markusheimerl/quadcopter/hardware/README.md

# quad
A quadcopter printed circuit board  

## How to use
Import .epro file at [https://pro.easyeda.com/editor](https://pro.easyeda.com/editor)

## Quickview

### Drone
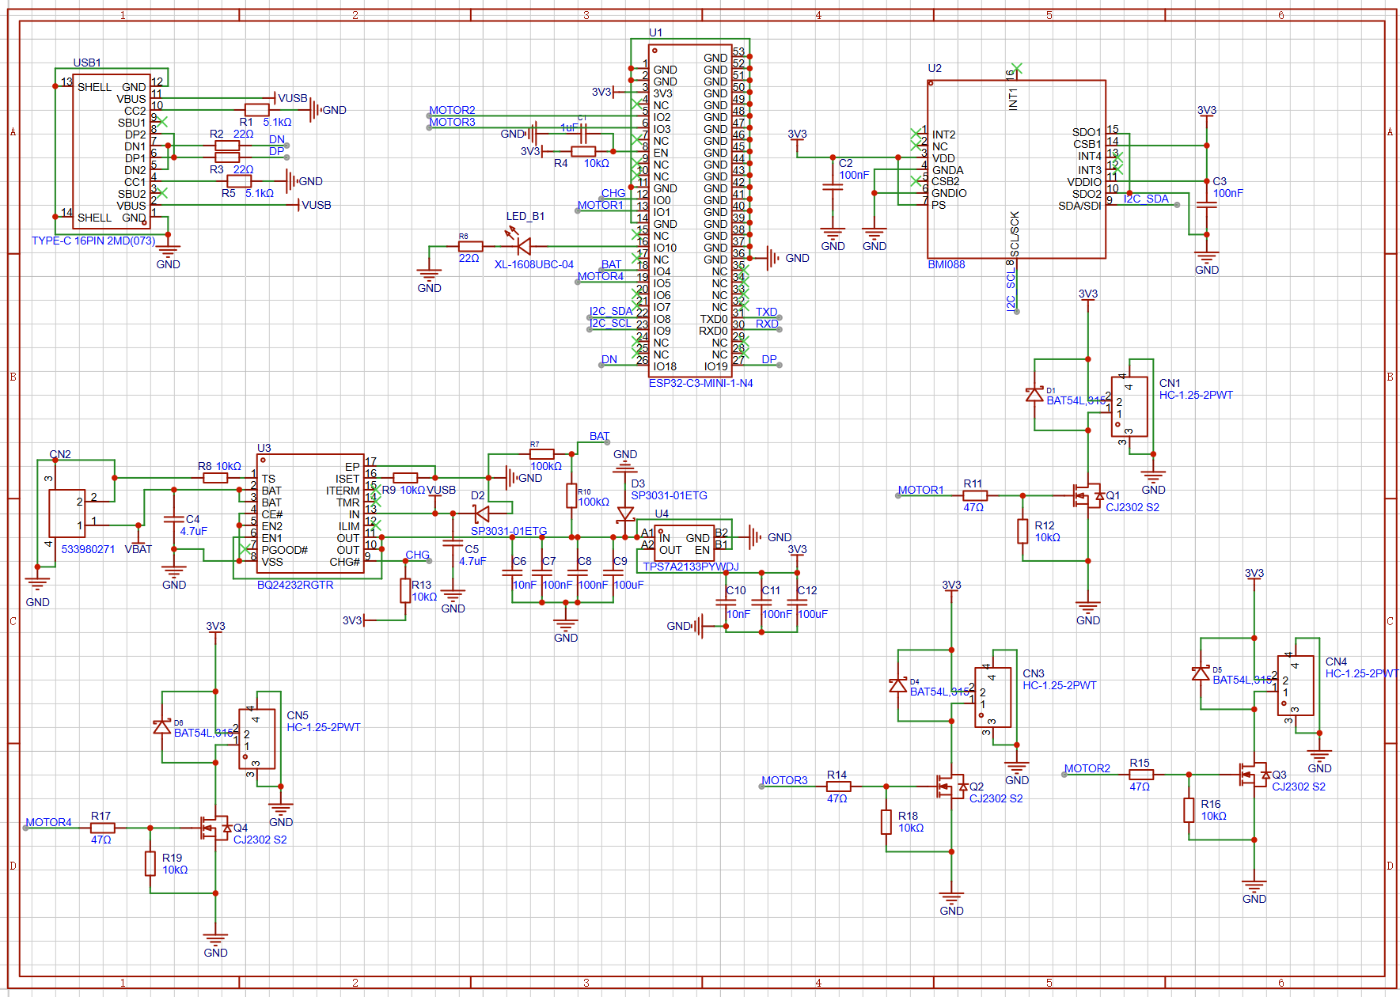
[picture p1: hardware/img/2025_11_15_drone_sch.png]
Drone Schematic

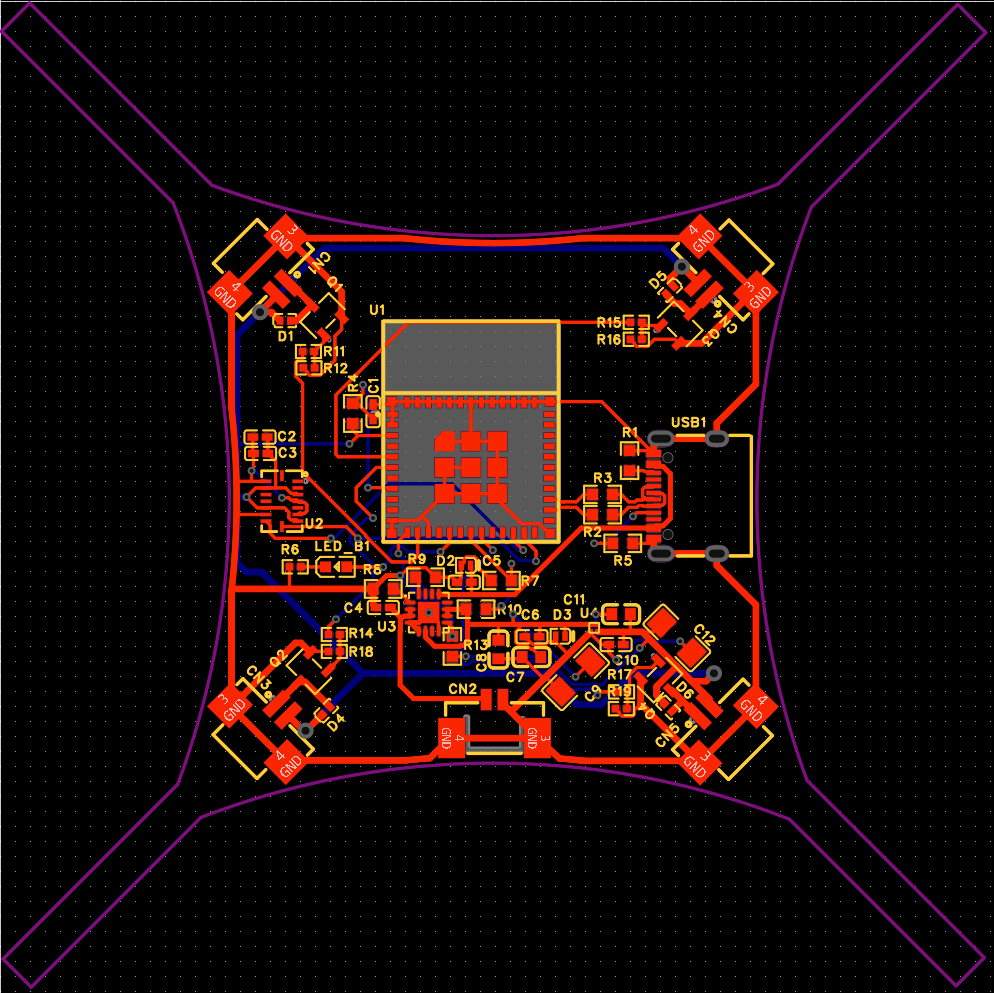
[picture p2: hardware/img/2025_11_15_drone_pcb.png]
Drone PCB


### ESP32
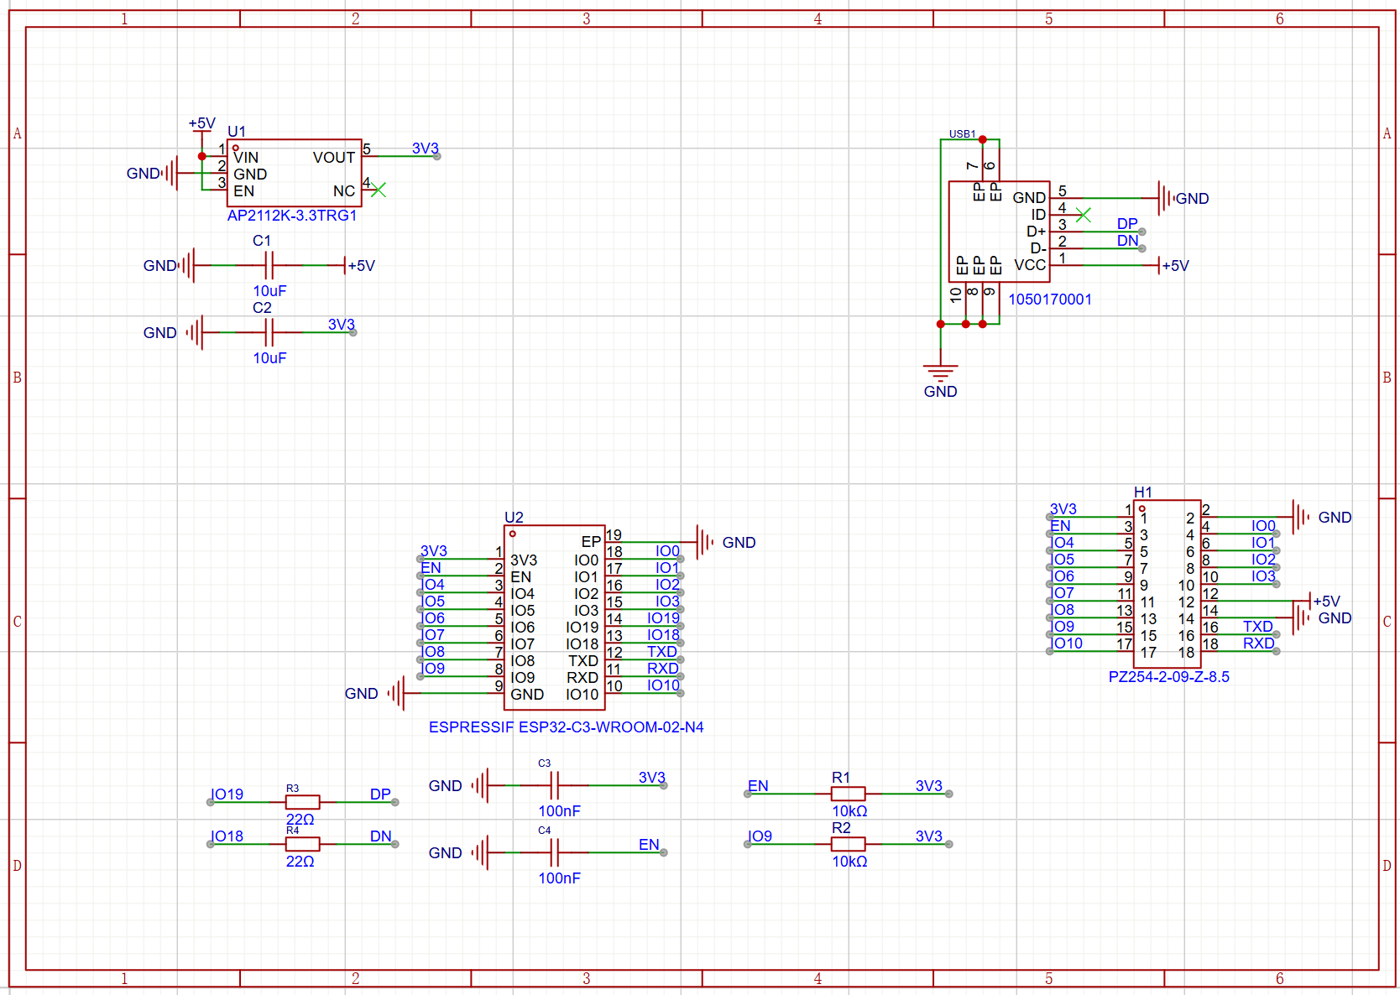
[picture p3: hardware/img/2025_10_02_esp32_sch.png]
ESP32 Schematic

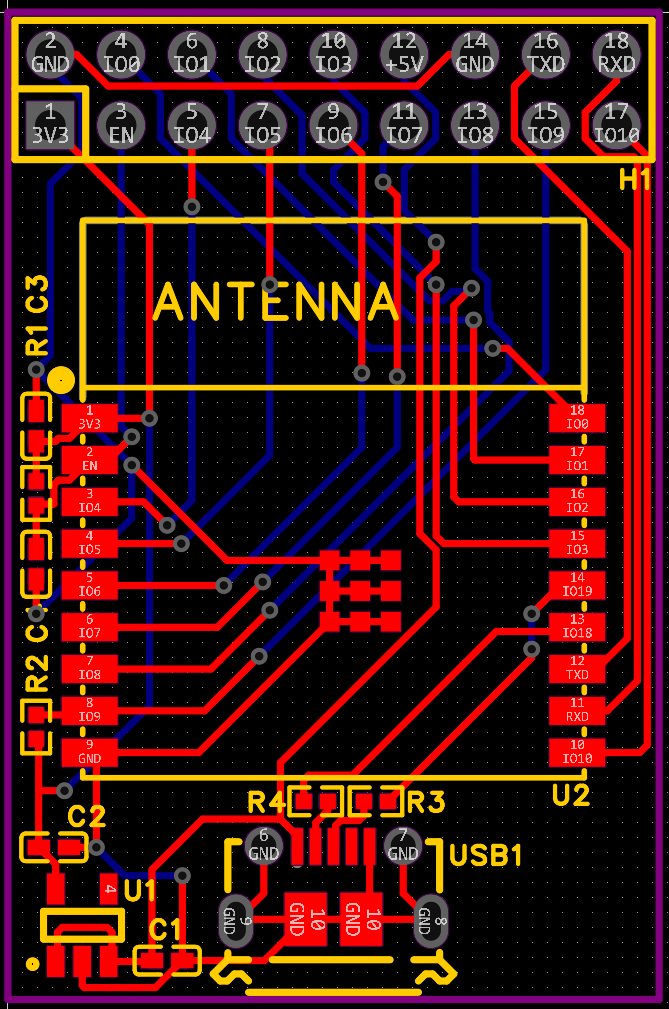
[picture p4: hardware/img/2025_10_02_esp32_pcb.png]
ESP32 PCB


### USB2SPI
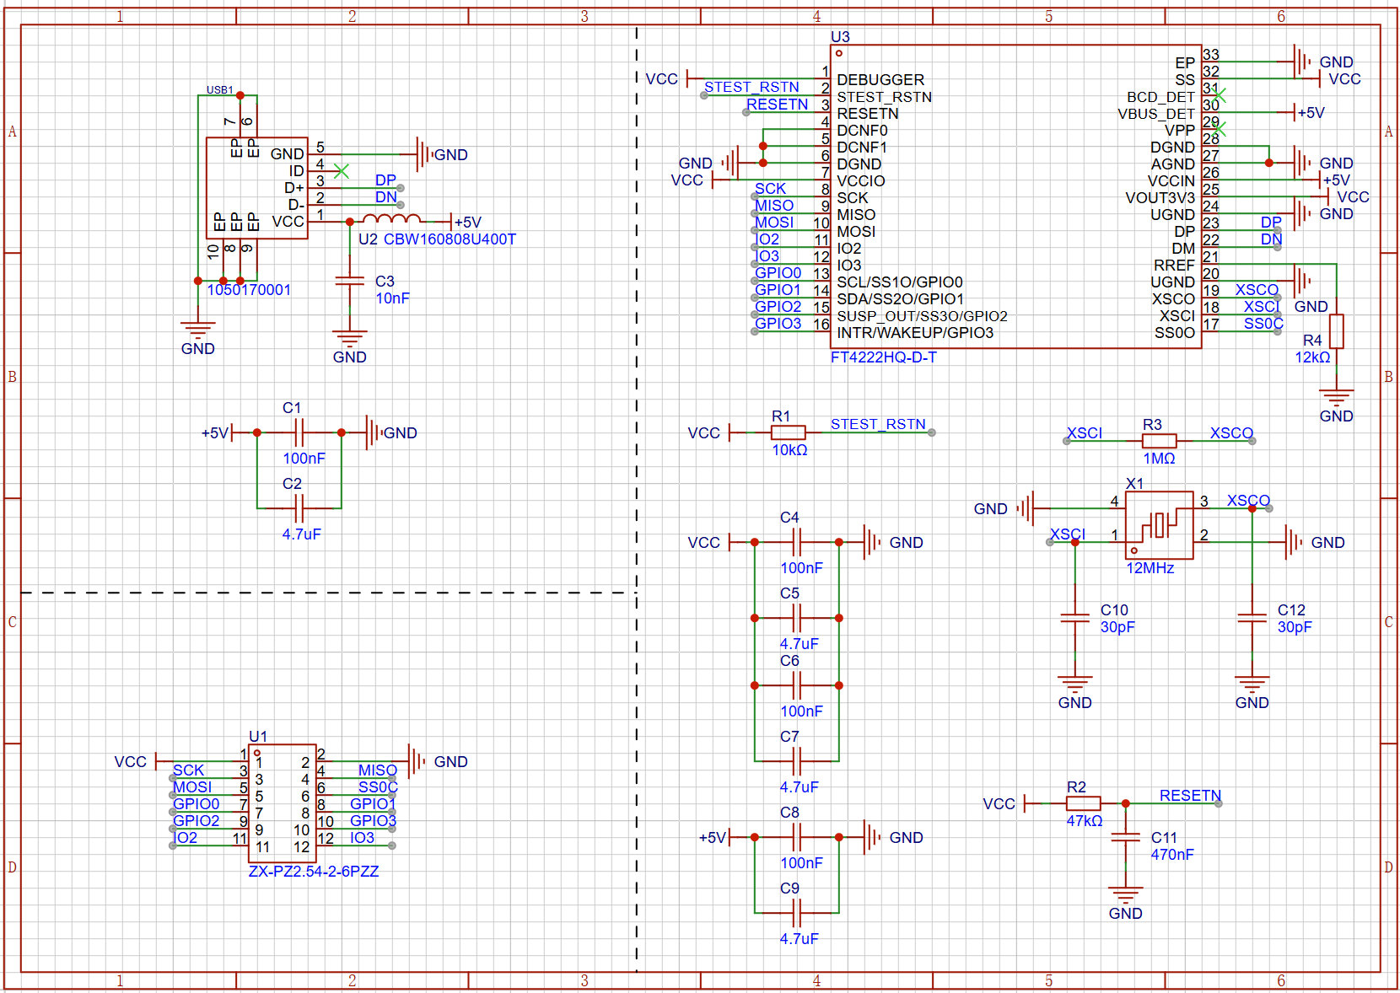
[picture p5: hardware/img/2025_09_11_usb2spi_sch.png]
FTDI Schematic

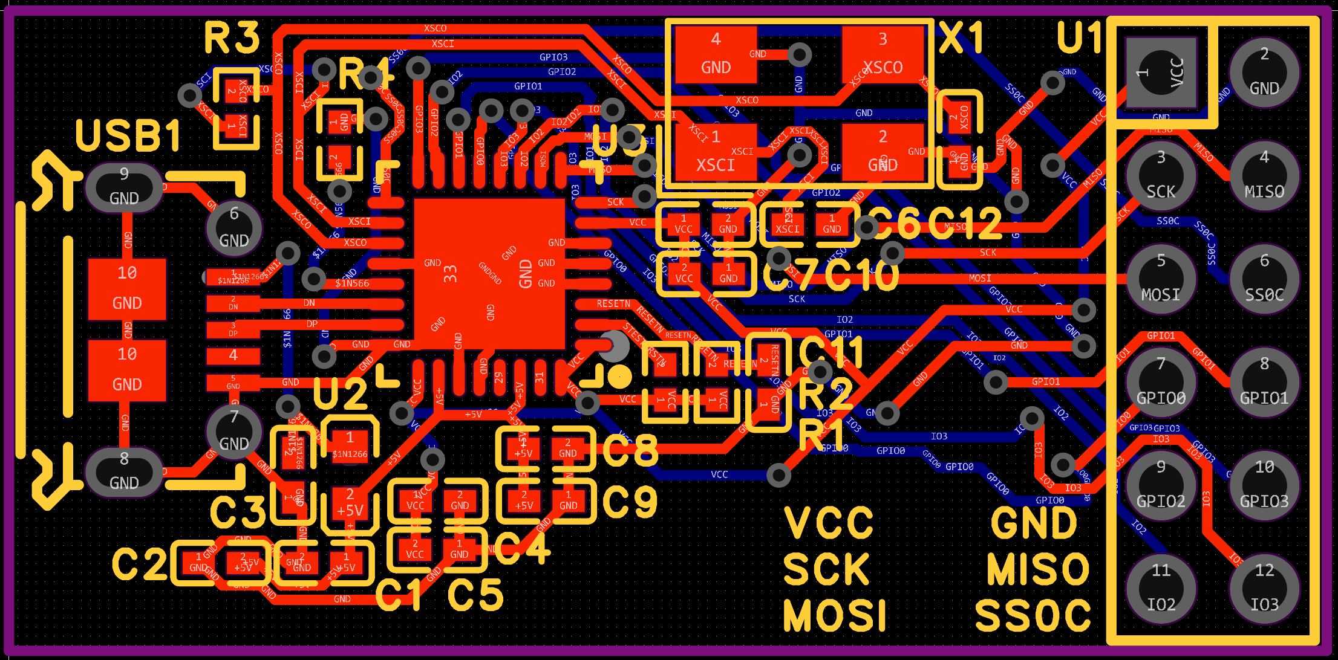
[picture p6: hardware/img/2025_09_11_usb2spi_pcb.png]
FTDI PCB


### FPGA
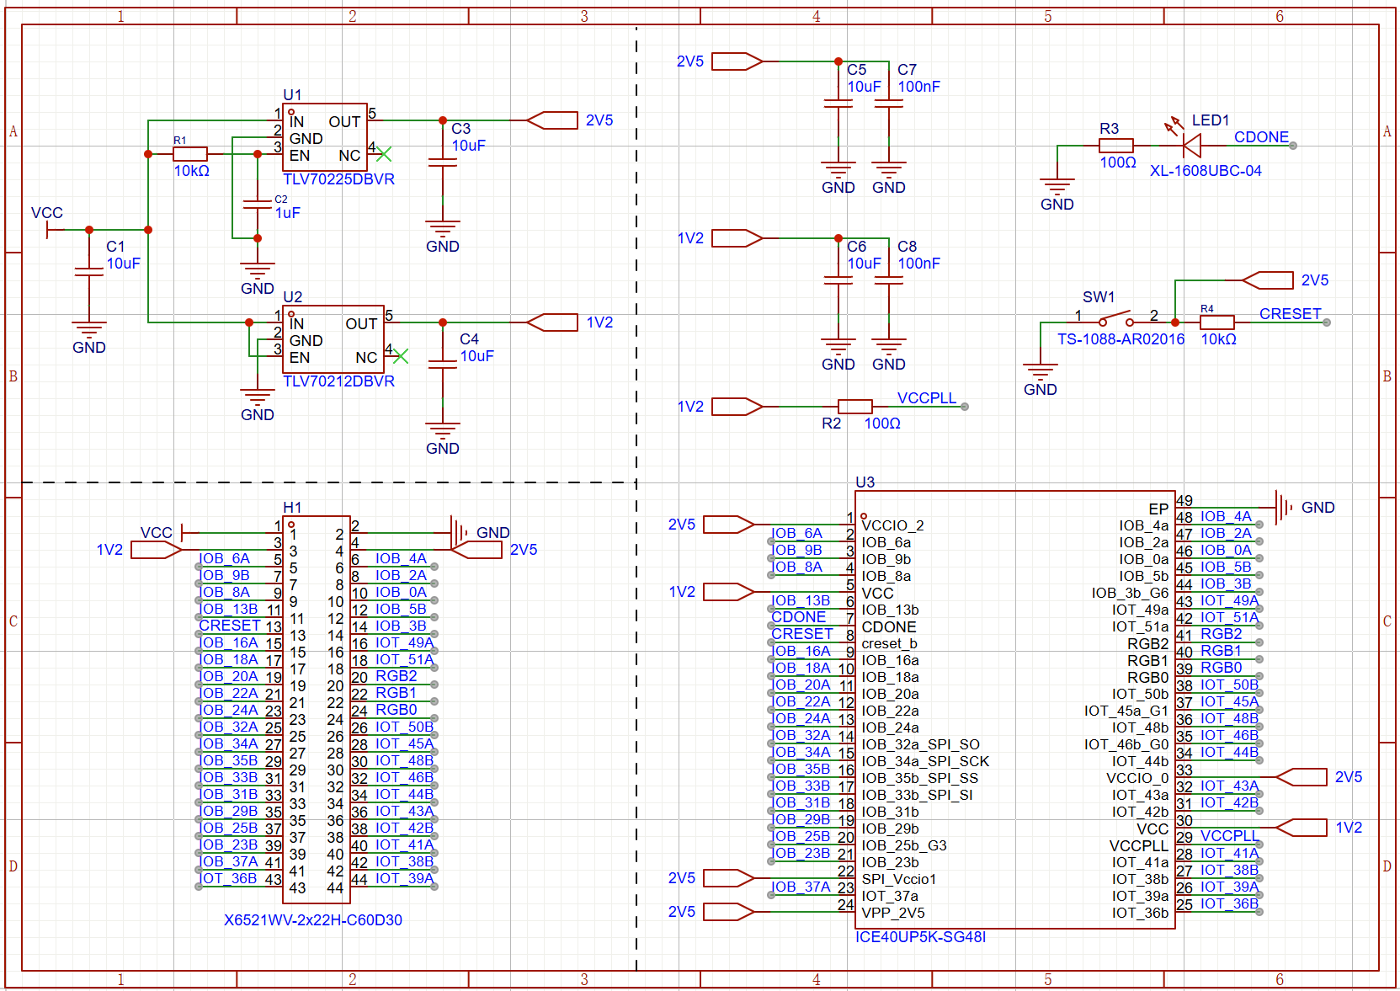
[picture p7: hardware/img/2025_08_20_fpga_sch.png]
FPGA Schematic

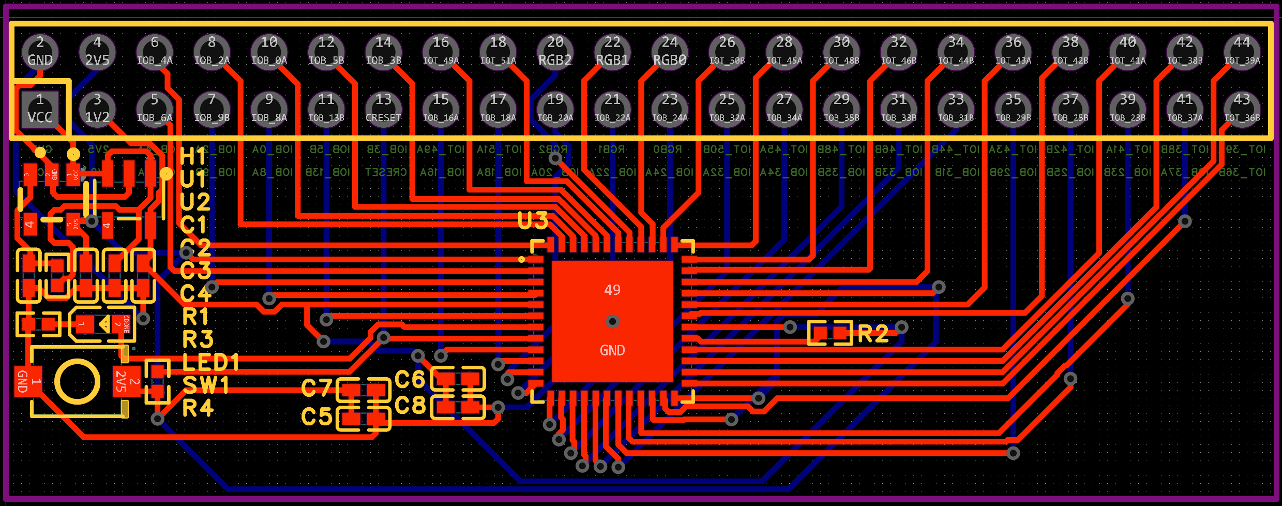
[picture p8: hardware/img/2025_08_20_fpga_pcb.png]
FPGA PCB


### DC
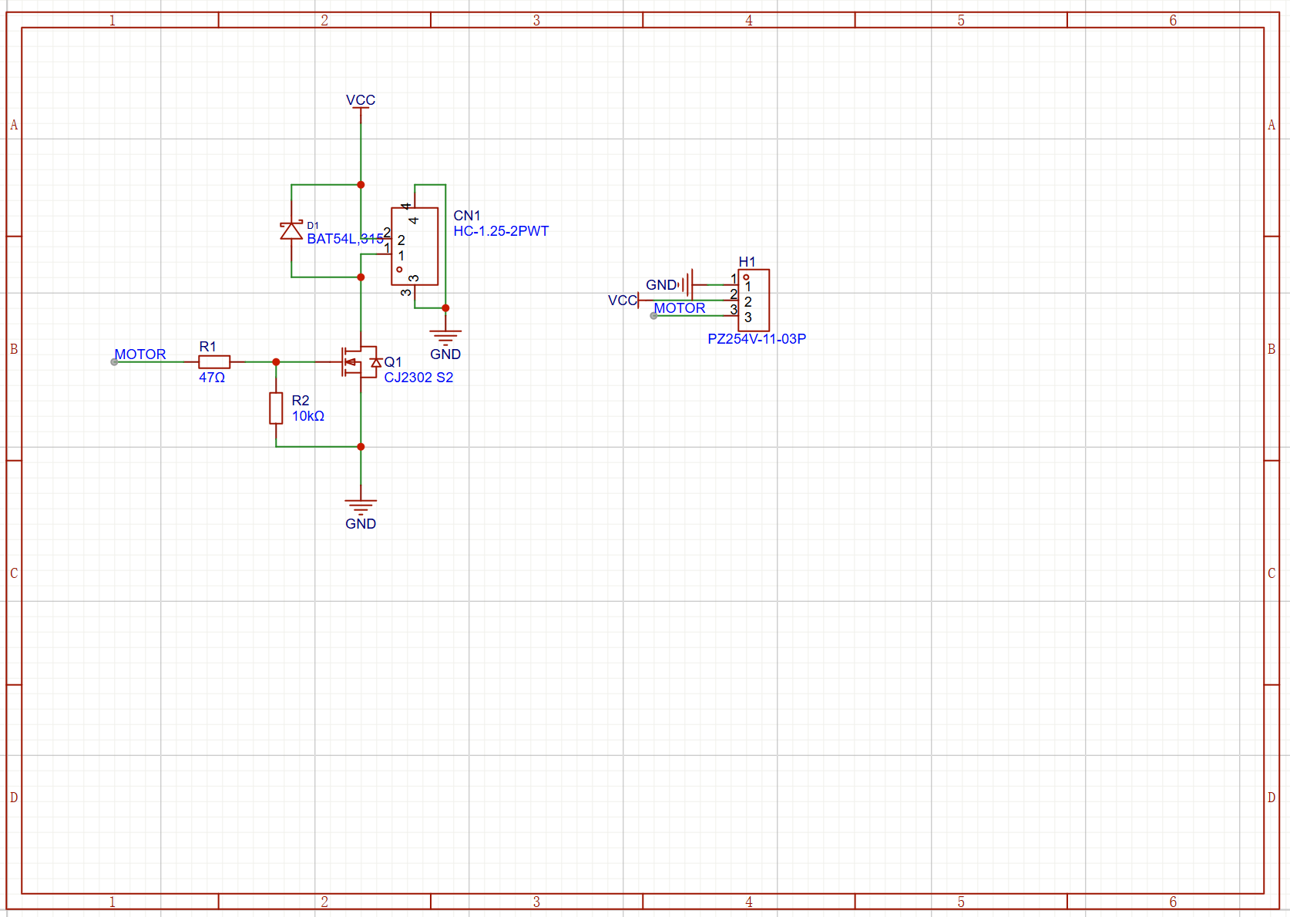
[picture p9: hardware/img/2025_09_06_dc_sch.png]
DC Schematic

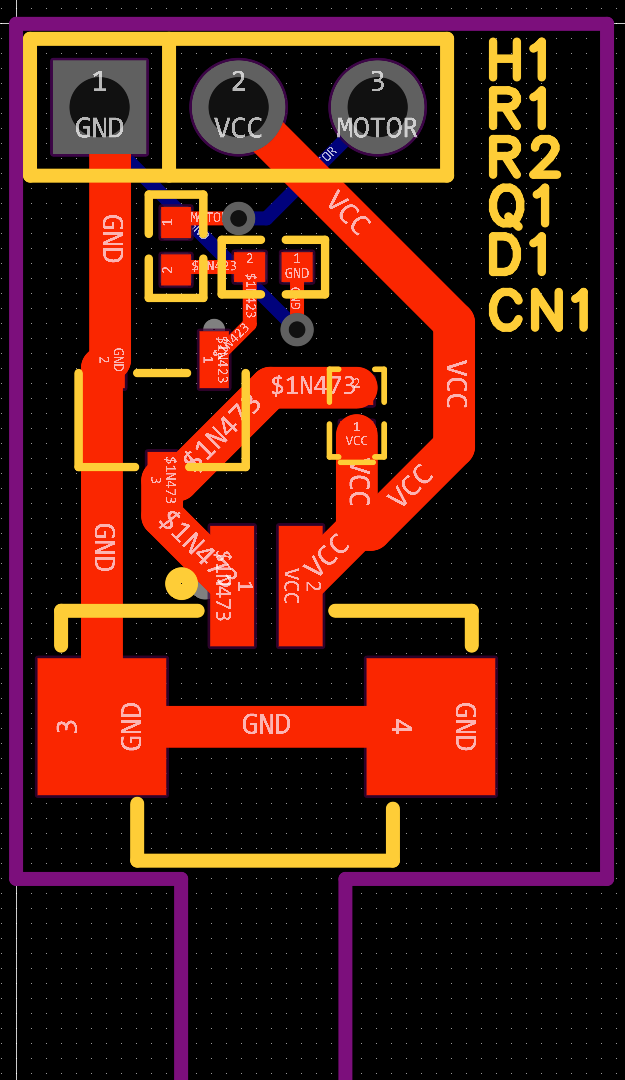
[picture p10: hardware/img/2025_09_06_dc_pcb.png]
DC PCB


### IMU
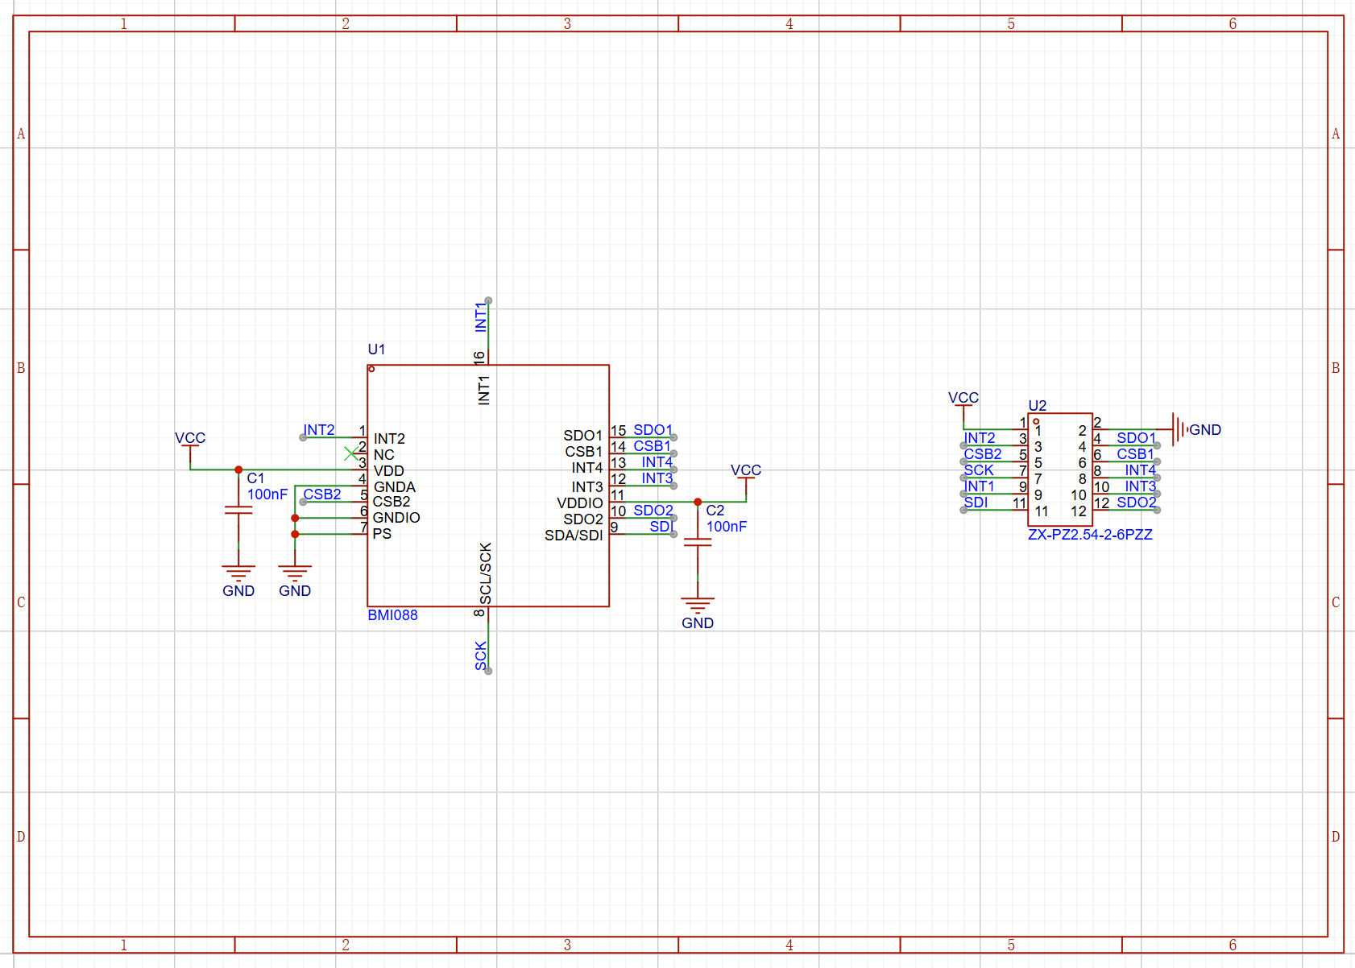
[picture p11: hardware/img/2025_07_18_imu_sch.png]
IMU Schematic

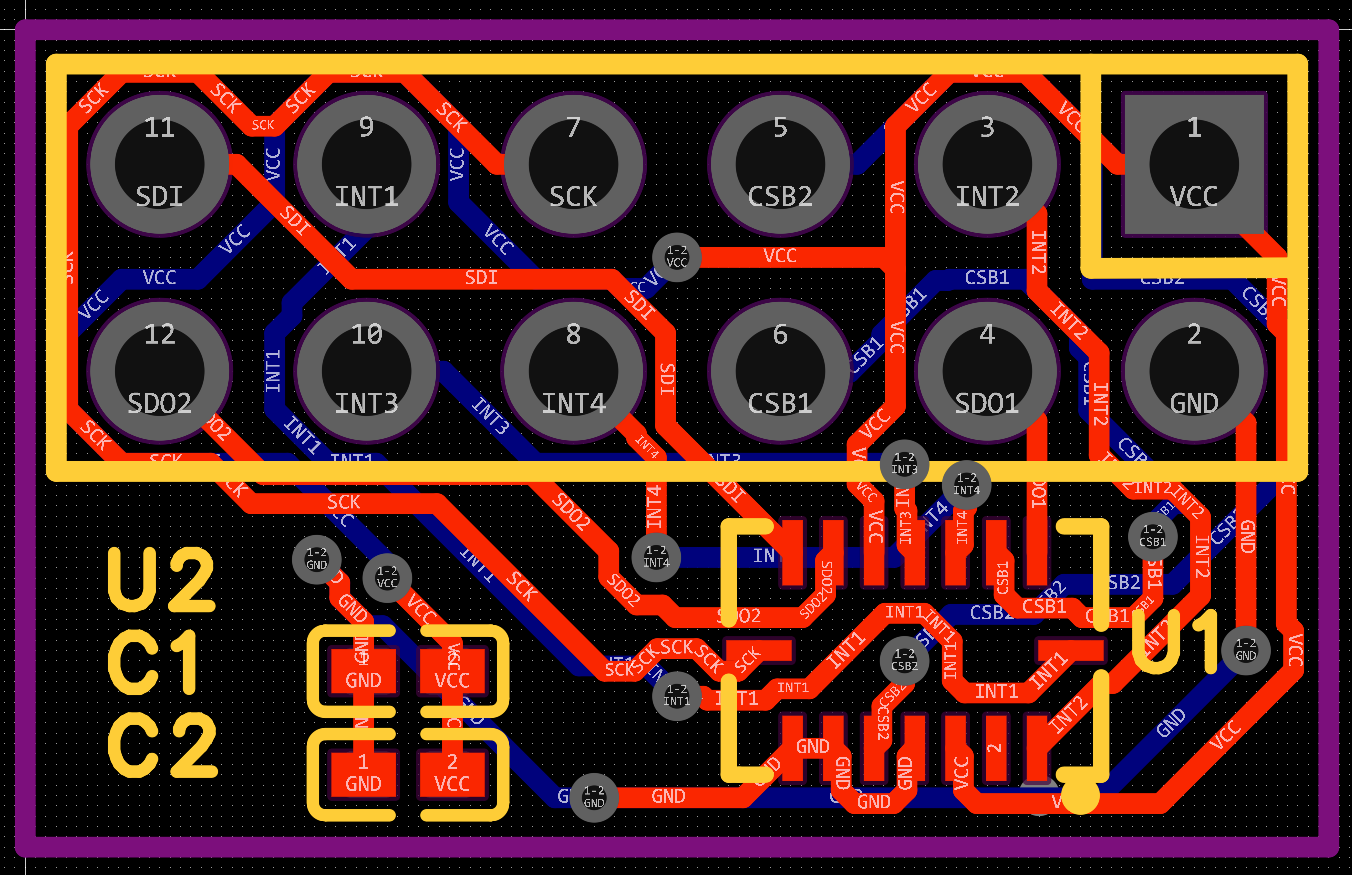
[picture p12: hardware/img/2025_07_18_imu_pcb.png]
IMU PCB


### Flash
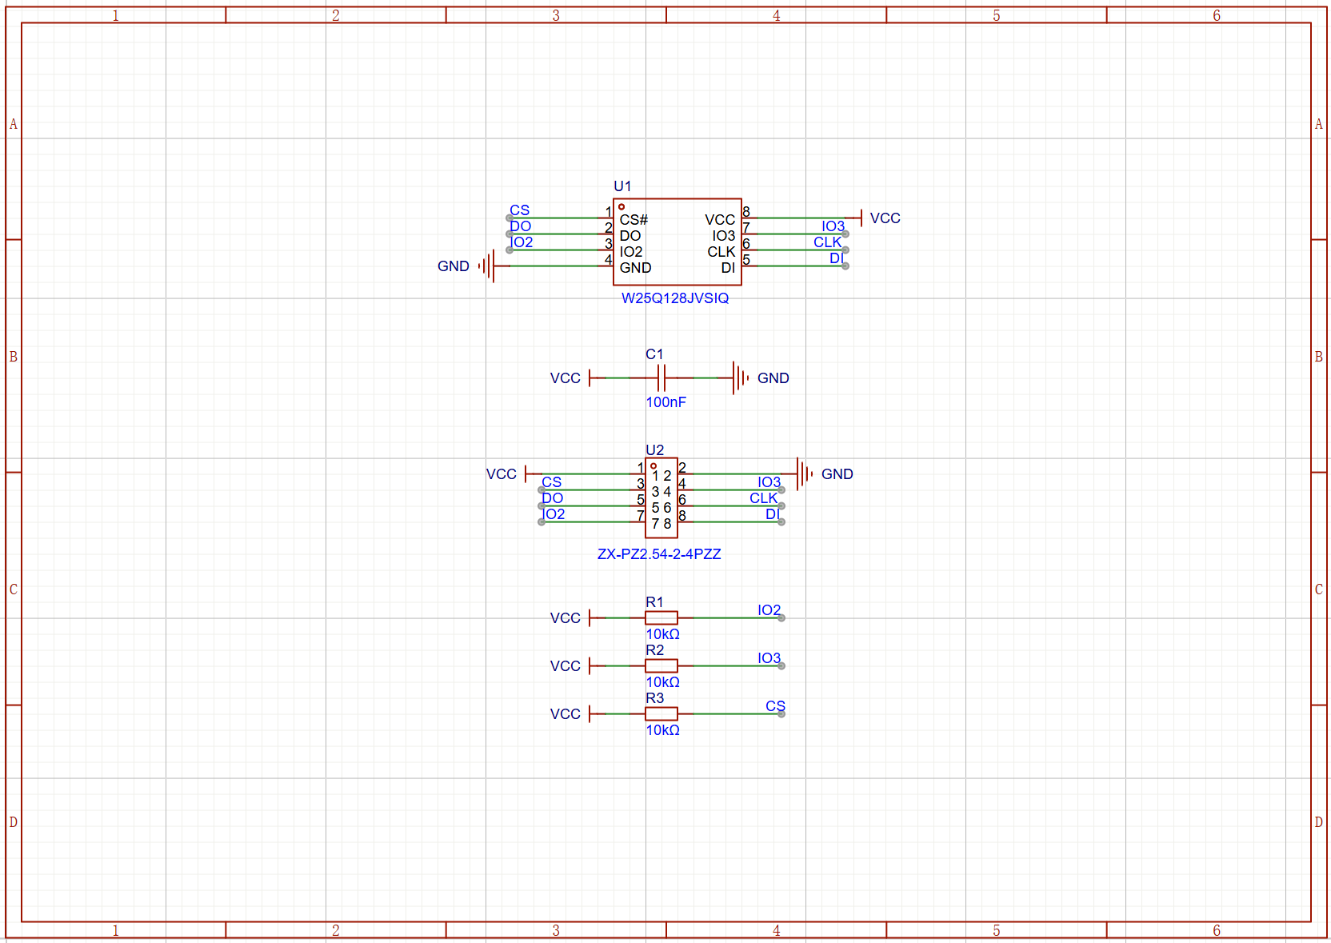
[picture p13: hardware/img/2025_09_11_flash_sch.png]
Flash Schematic

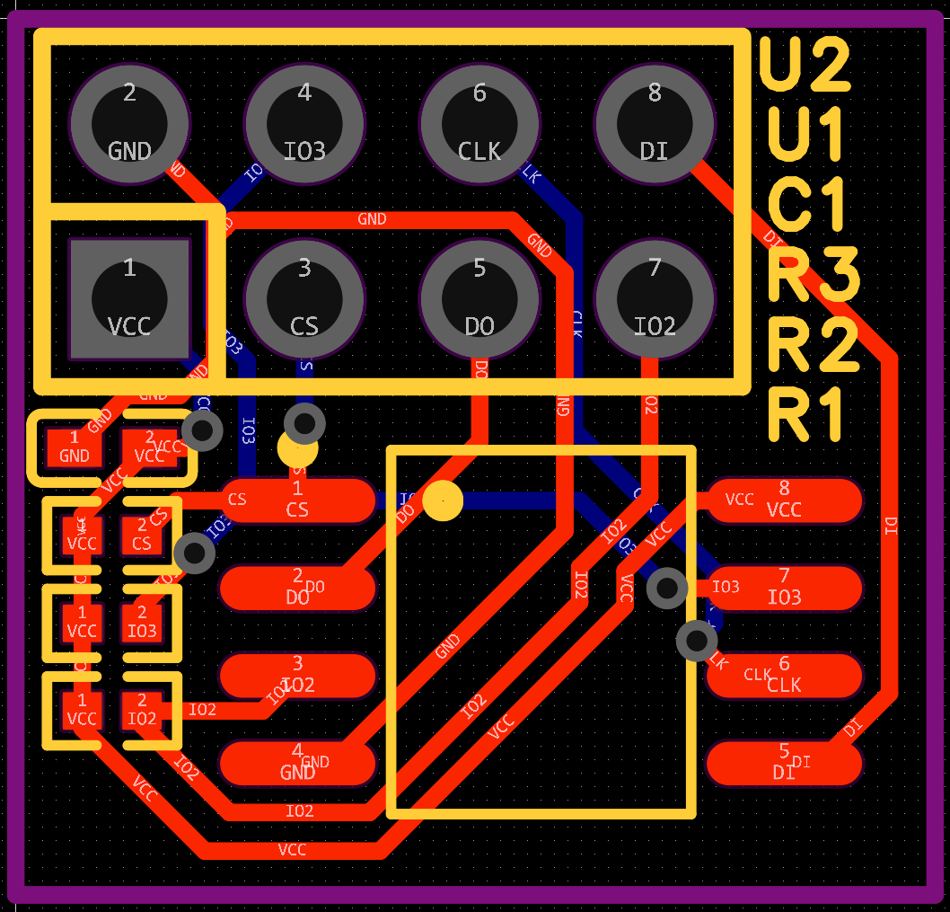
[picture p14: hardware/img/2025_09_11_flash_pcb.png]
Flash PCB


### LEDs
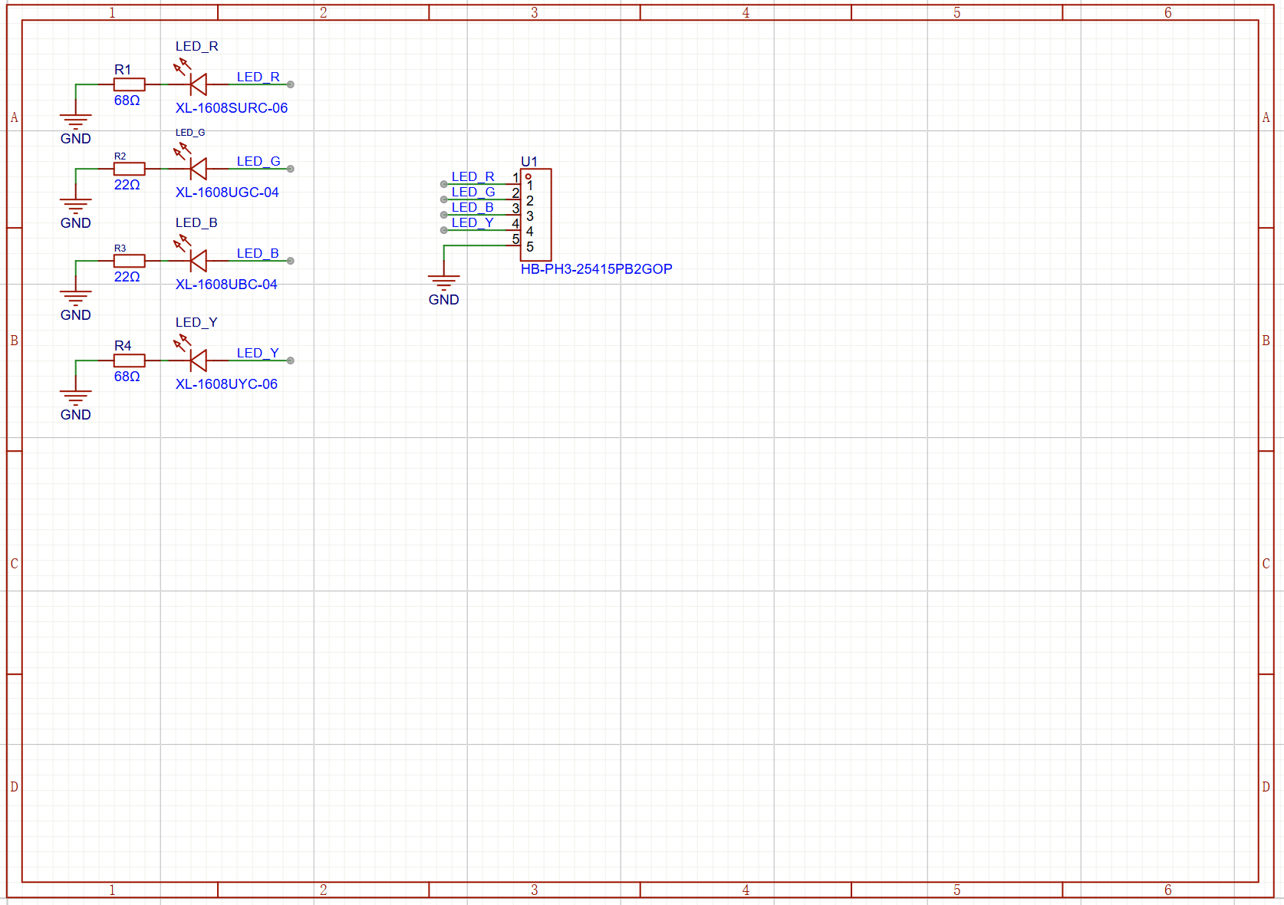
[picture p15: hardware/img/2025_08_23_leds_sch.png]
LEDs Schematic

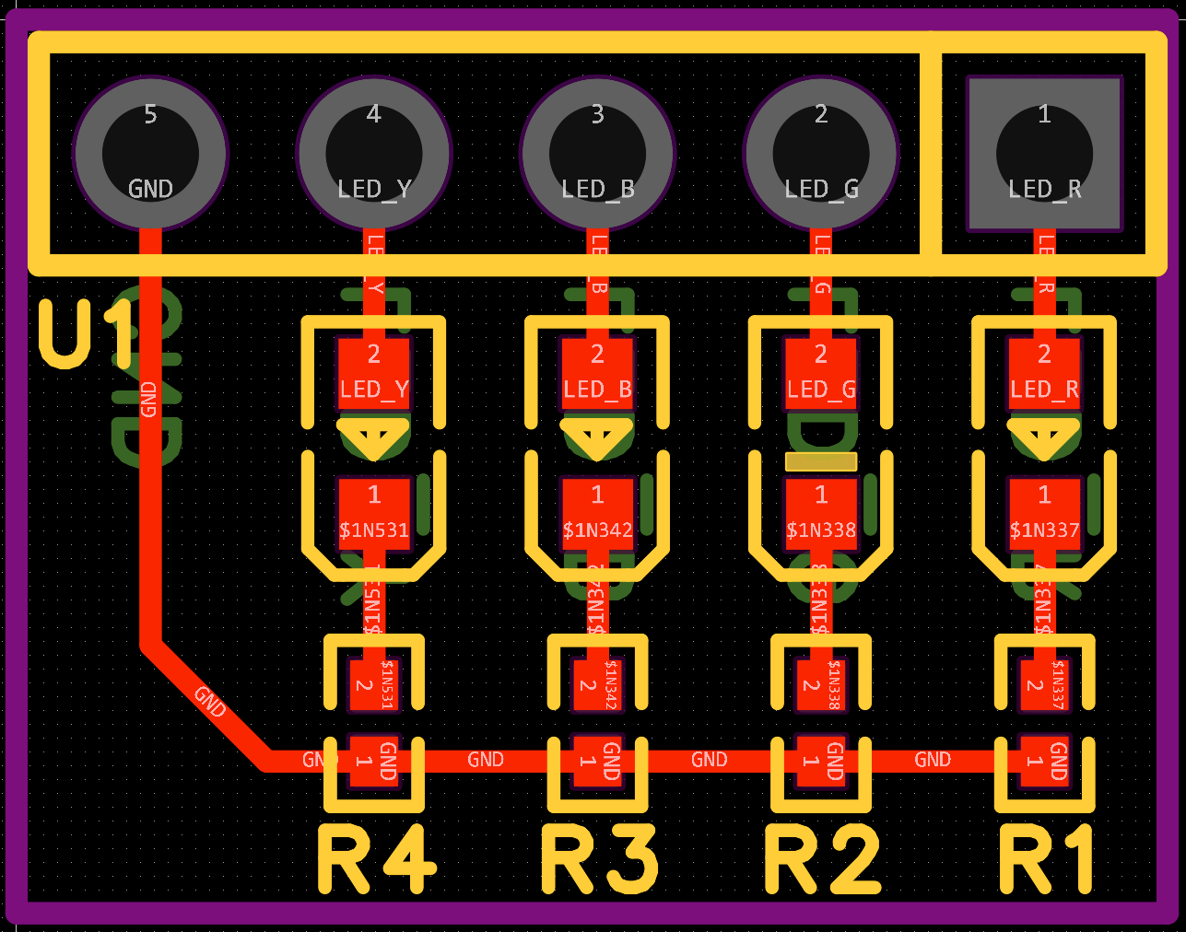
[picture p16: hardware/img/2025_08_23_leds_pcb.png]
LEDs PCB
