markusheimerl/quadcopter/raytracer/README.md

# raytracer
A ray tracer implementation

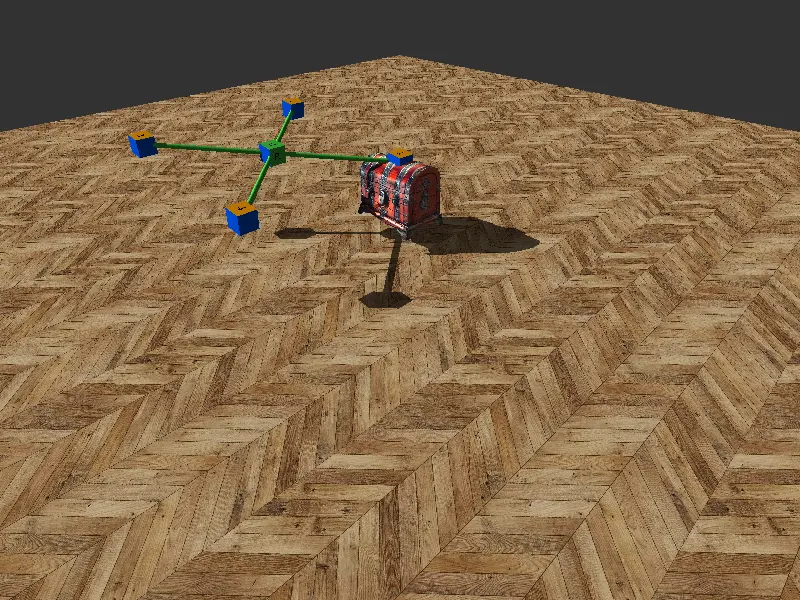
[picture p18: raytracer/20260307_094655_rendering.webp]
animation


## How to run
```
sudo apt update
sudo apt install clang libwebp-dev libomp-dev time
make run -j 4
```
