markusheimerl/quadcopter/pcb/img/pcb.png

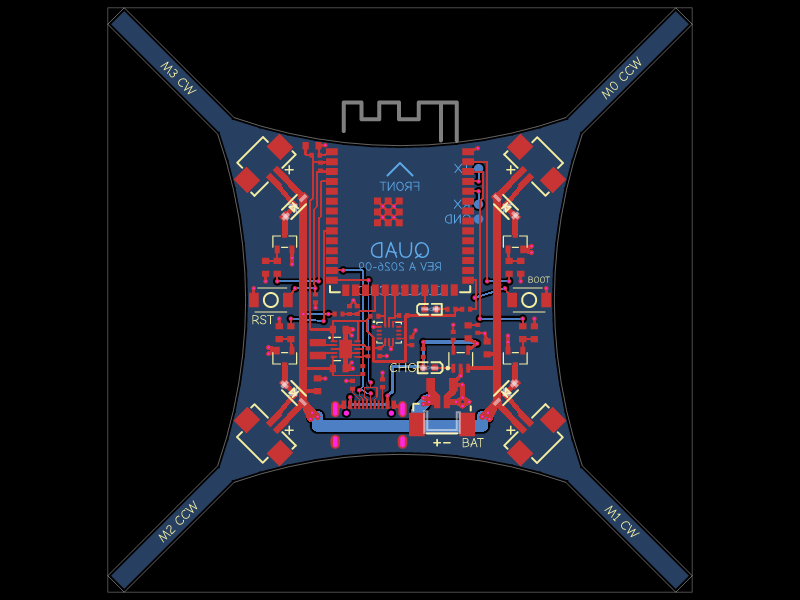
pcb/img/pcb.png
