markusheimerl/quadcopter/raytracer/assets/drone.obj

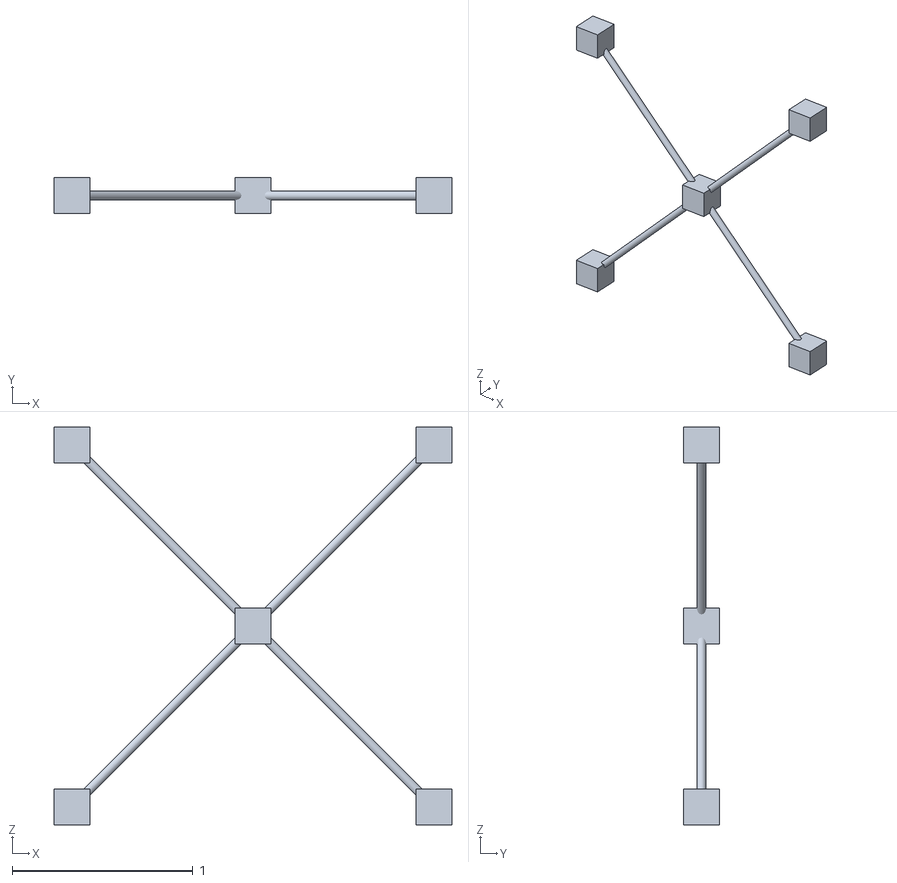
[picture p20: CAD file, 2026-03-07]
raytracer/assets/drone.obj
2.20 x 0.2 x 2.20
