markusheimerl/quadcopter/raytracer/assets/ground.obj

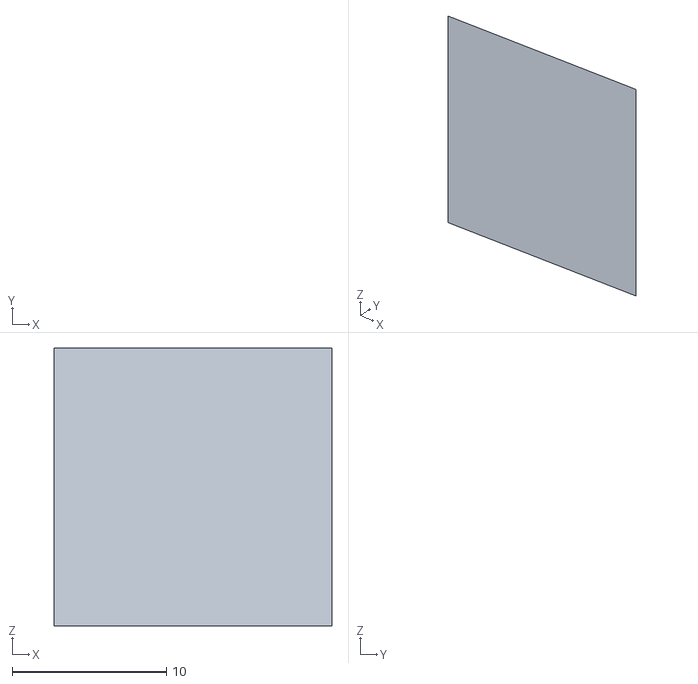
[picture p21: CAD file, 2026-03-07]
raytracer/assets/ground.obj
18.0 x 0 x 18.0
