markusheimerl/quadcopter/raytracer/assets/treasure.obj

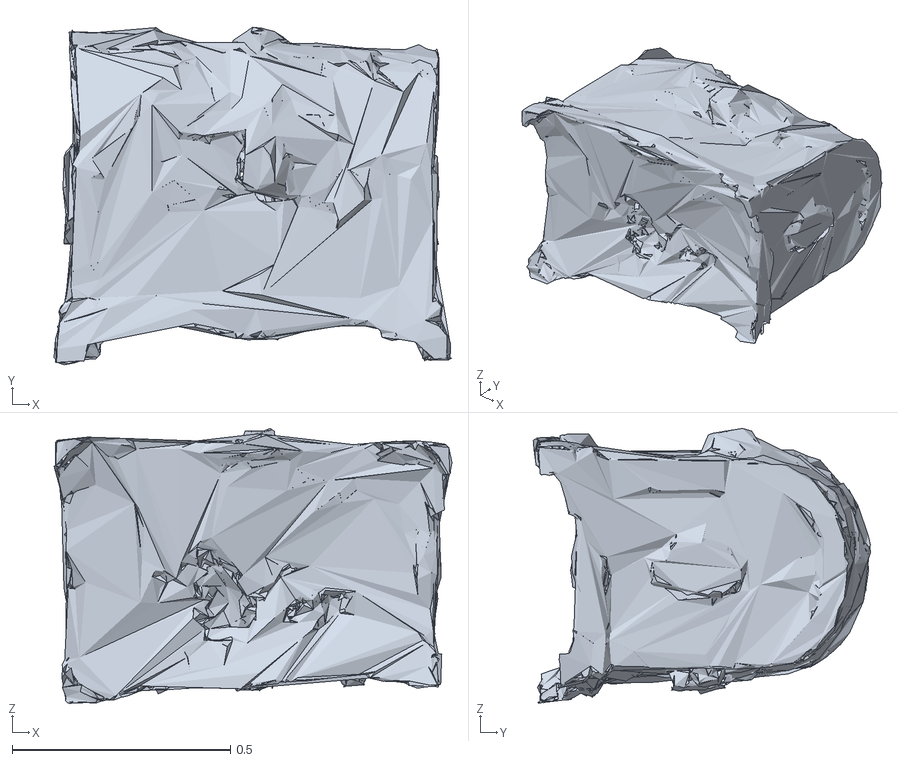
[picture p22: CAD file, 2026-03-07]
raytracer/assets/treasure.obj
0.912 x 0.774 x 0.631
