markusheimerl/quadcopter/(list of files, drawings)

Other design files:
hardware/2025_07_18_imu.epro
hardware/2025_08_20_fpga.epro
hardware/2025_08_23_leds.epro
hardware/2025_09_06_dc.epro
hardware/2025_09_11_flash.epro
hardware/2025_09_11_usb2spi.epro
hardware/2025_10_02_esp32.epro
hardware/2025_11_15_drone.epro
hardware/ProPrj_2026_05_12_drone_2026-05-23.epro
hardware/ProPrj_2026_05_15_drone_2026-05-23.epro
