markusheimerl/quadcopter/pcb/kicad/quad.kicad_pcb

## KiCad design pcb/kicad/quad.kicad_pcb (2026-09-28)

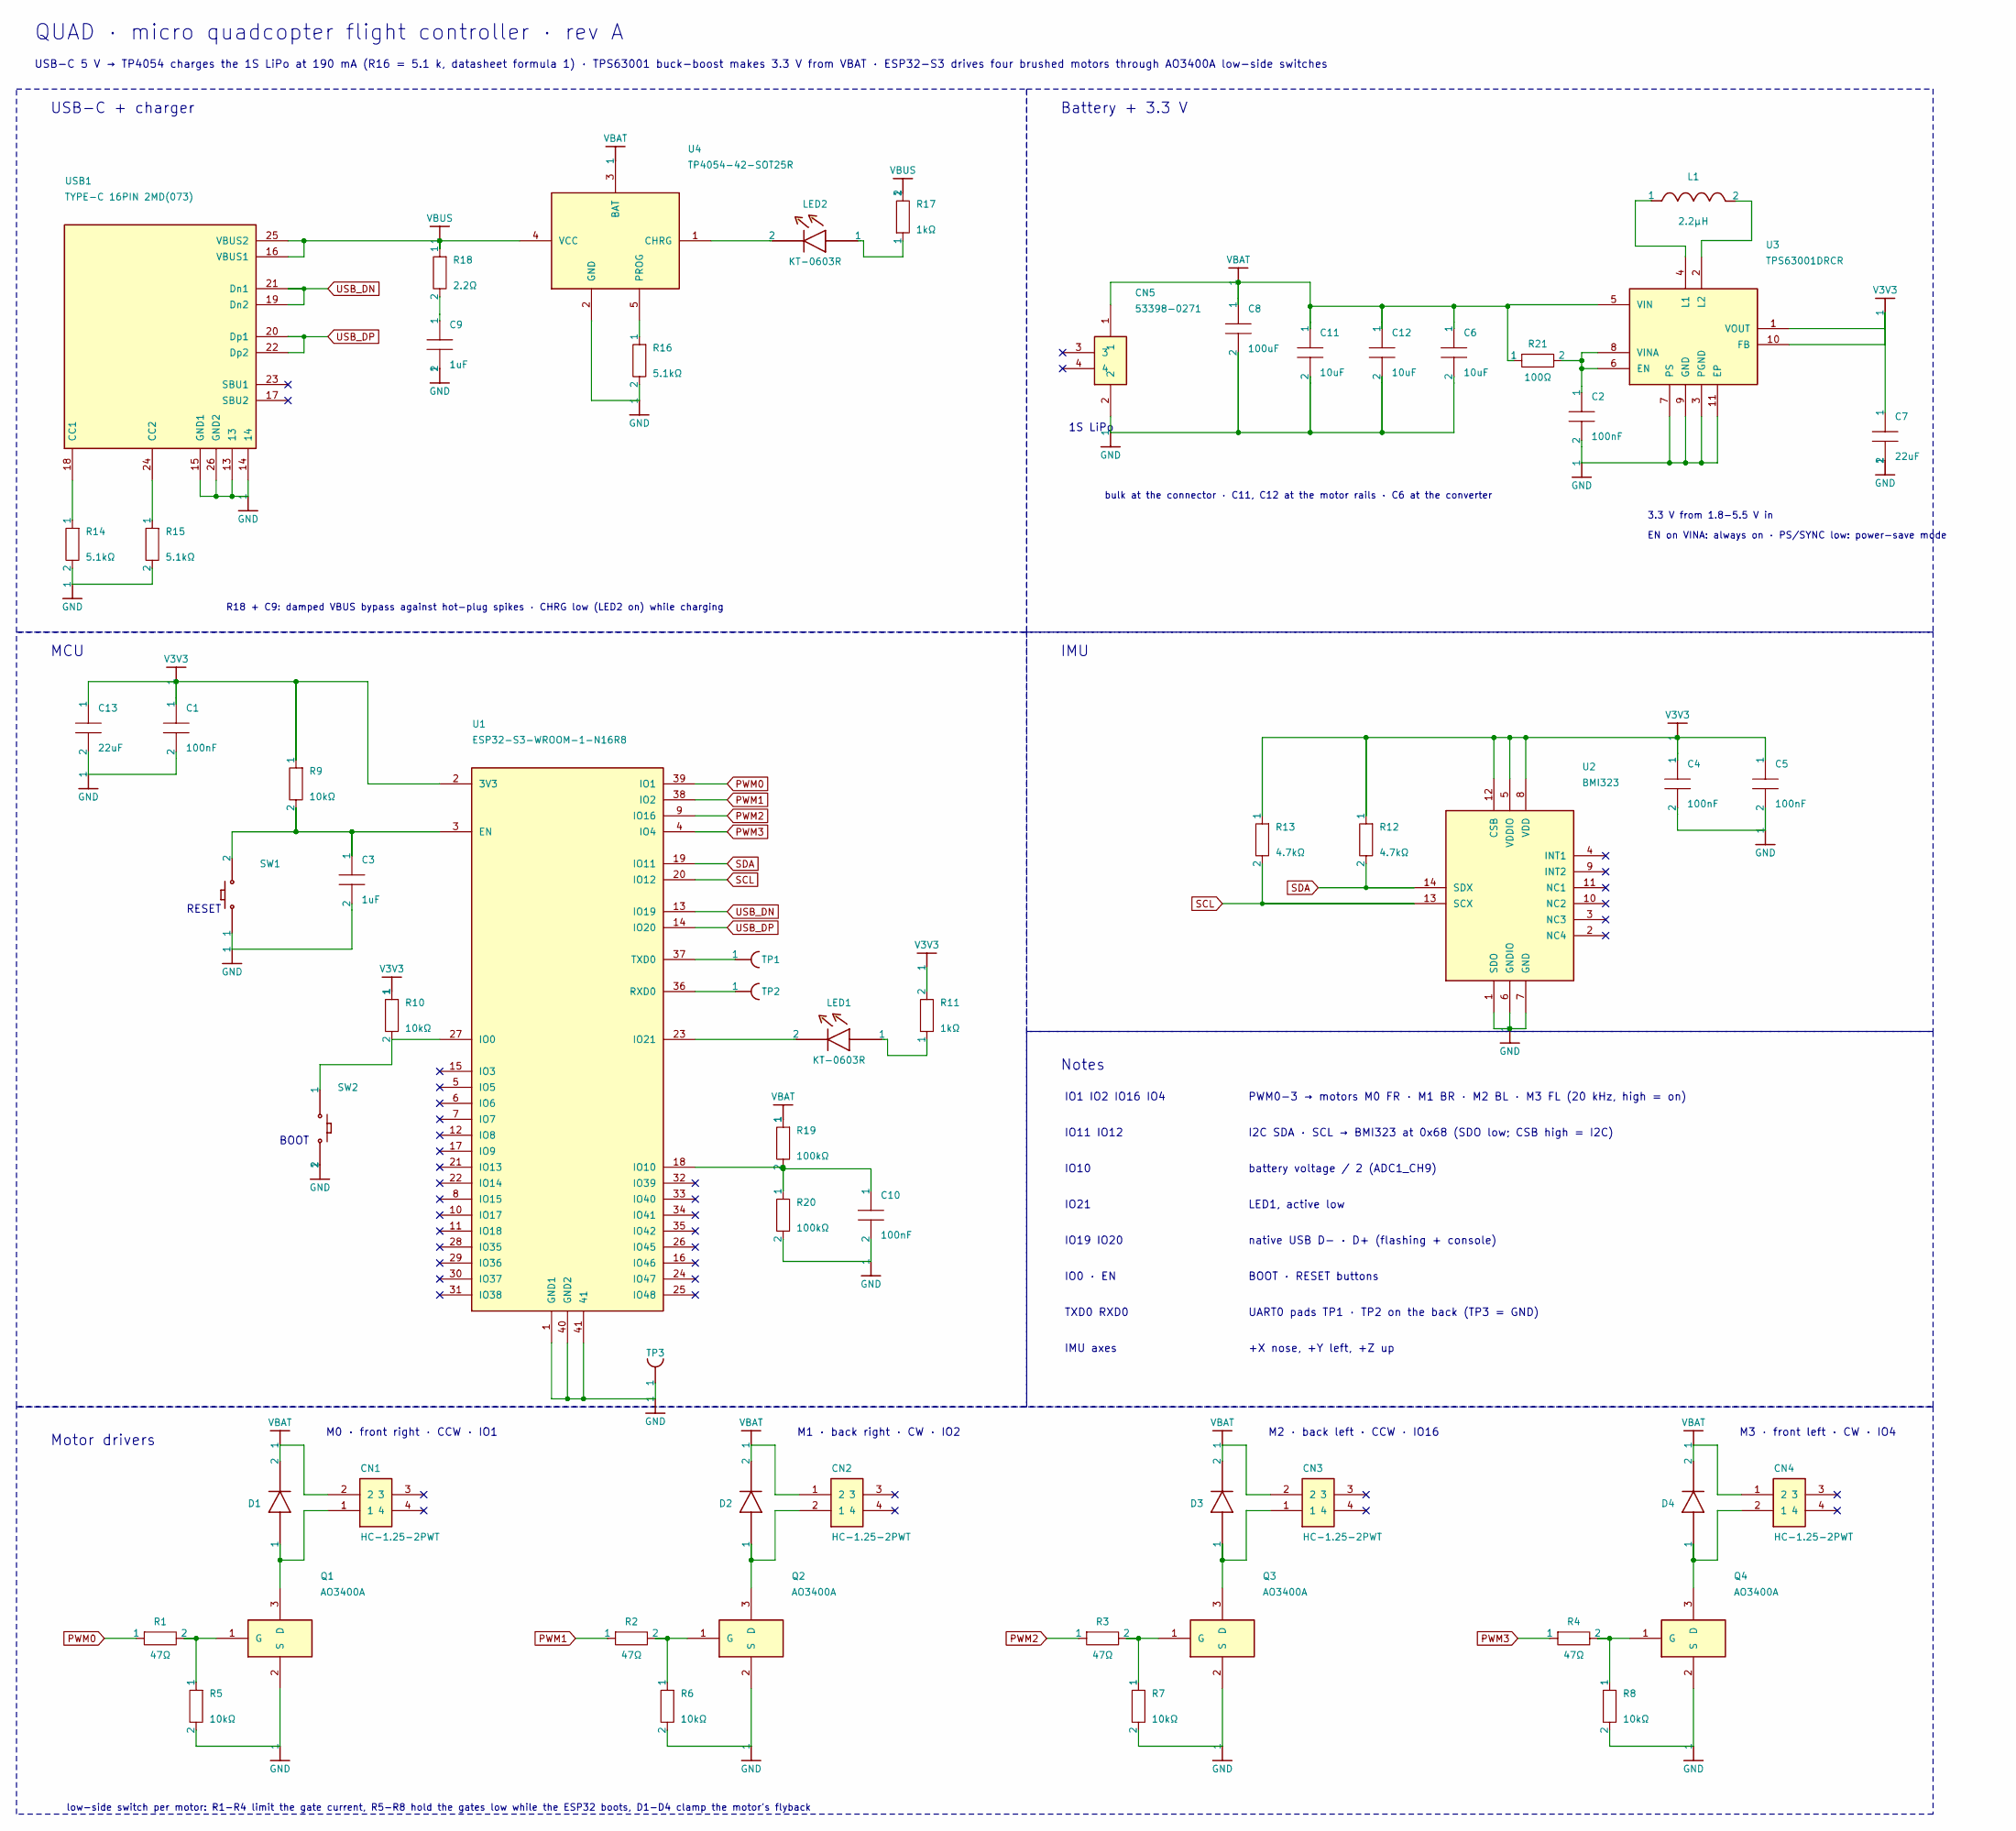
[picture p23: schematic quad.kicad_sch]

Parts:
C1, C2, C4, C5, C10: 100nF
C3, C9: 1uF
C6, C11, C12: 10uF
C7, C13: 22uF
C8: 100uF
CN1, CN2, CN3, CN4: HC-1.25-2PWT
CN5: 53398-0271
D1, D2, D3, D4: B5819W
L1: 2.2µH
LED1, LED2: KT-0603R
Q1, Q2, Q3, Q4: AO3400A
R1, R2, R3, R4: 47Ω
R5, R6, R7, R8, R9, R10: 10kΩ
R11, R17: 1kΩ
R12, R13: 4.7kΩ
R14, R15, R16: 5.1kΩ
R18: 2.2Ω
R19, R20: 100kΩ
R21: 100Ω
SW1: SW1
SW2: SW2
TP1: TP1
TP2: TP2
TP3: TP3
U1: ESP32-S3-WROOM-1-N16R8
U2: BMI323
U3: TPS63001DRCR
U4: TP4054-42-SOT25R
USB1: TYPE-C 16PIN 2MD(073)

Connections:
CC1: R14.1, USB1.18 (CC1)
CC2: R15.1, USB1.24 (CC2)
CHG_A: LED2.1, R17.1
CHRG: LED2.2, U4.1 (CHRG)
EN: C3.1, R9.2, SW1.2, U1.3 (EN)
G0: Q1.1 (G), R1.2, R5.1
G1: Q2.1 (G), R2.2, R6.1
G2: Q3.1 (G), R3.2, R7.1
G3: Q4.1 (G), R4.2, R8.1
GND: C1.2, C2.2, C3.2, C4.2, C5.2, C6.2, C7.2, C8.2, C9.2, C10.2, C11.2, C12.2, C13.2, CN5.2, Q1.2 (S), Q2.2 (S), Q3.2 (S), Q4.2 (S), R5.2, R6.2, R7.2, R8.2, R14.2, R15.2, R16.2, R20.2, SW1.1, SW2.2, TP3.1, U1.1 (GND1), U1.40 (GND2), U1.41, U2.1 (SDO), U2.6 (GNDIO), U2.7 (GND), U3.3 (PGND), U3.7 (PS), U3.9 (GND), U3.11 (EP), U4.2 (GND), USB1.13, USB1.14, USB1.15 (GND1), USB1.26 (GND2)
IO0: R10.2, SW2.1, U1.27 (IO0)
LED: LED1.2, U1.23 (IO21)
LED_A: LED1.1, R11.1
LX1: L1.1, U3.4 (L1)
LX2: L1.2, U3.2 (L2)
M0: CN1.1, D1.2 (1), Q1.3 (D)
M1: CN2.2 (1), D2.2 (1), Q2.3 (D)
M2: CN3.1, D3.2 (1), Q3.3 (D)
M3: CN4.2 (1), D4.2 (1), Q4.3 (D)
PROG: R16.1, U4.5 (PROG)
PWM0: R1.1, U1.39 (IO1)
PWM1: R2.1, U1.38 (IO2)
PWM2: R3.1, U1.9 (IO16)
PWM3: R4.1, U1.4 (IO4)
RXD0: TP2.1, U1.36 (RXD0)
SCL: R13.2, U1.20 (IO12), U2.13 (SCX)
SDA: R12.2, U1.19 (IO11), U2.14 (SDX)
TXD0: TP1.1, U1.37 (TXD0)
USB_DN: U1.13 (IO19), USB1.19 (Dn2), USB1.21 (Dn1)
USB_DP: U1.14 (IO20), USB1.20 (Dp1), USB1.22 (Dp2)
V3V3: C1.1, C4.1, C5.1, C7.1, C13.1, R9.1, R10.1, R11.2, R12.1, R13.1, U1.2 (3V3), U2.5 (VDDIO), U2.8 (VDD), U2.12 (CSB), U3.1 (VOUT), U3.10 (FB)
VBAT: C6.1, C8.1, C11.1, C12.1, CN1.2, CN2.1 (2), CN3.2, CN4.1 (2), CN5.1, D1.1 (2), D2.1 (2), D3.1 (2), D4.1 (2), R19.1, R21.1, U3.5 (VIN), U4.3 (BAT)
VBUS: R17.2, R18.1, U4.4 (VCC), USB1.16 (VBUS1), USB1.25 (VBUS2)
VBUS_C: C9.1, R18.2
VINA: C2.1, R21.2, U3.6 (EN), U3.8 (VINA)
VSENSE: C10.1, R19.2, R20.1, U1.18 (IO10)

Notes on the sheet:
QUAD · micro quadcopter flight controller · rev A
USB-C 5 V → TP4054 charges the 1S LiPo at 190 mA (R16 = 5.1 k, datasheet formula 1) · TPS63001 buck-boost makes 3.3 V from VBAT · ESP32-S3 drives four brushed motors through AO3400A low-side switches
USB-C + charger
Battery + 3.3 V
MCU
IMU
Notes
IO1 IO2 IO16 IO4
PWM0-3 → motors M0 FR · M1 BR · M2 BL · M3 FL (20 kHz, high = on)
IO11 IO12
I2C SDA · SCL → BMI323 at 0x68 (SDO low; CSB high = I2C)
IO10
battery voltage / 2 (ADC1_CH9)
IO21
LED1, active low
IO19 IO20
native USB D- · D+ (flashing + console)
IO0 · EN
BOOT · RESET buttons
TXD0 RXD0
UART0 pads TP1 · TP2 on the back (TP3 = GND)
IMU axes
+X nose, +Y left, +Z up
1S LiPo
bulk at the connector · C11, C12 at the motor rails · C6 at the converter
3.3 V from 1.8-5.5 V in
EN on VINA: always on · PS/SYNC low: power-save mode
R18 + C9: damped VBUS bypass against hot-plug spikes · CHRG low (LED2 on) while charging
low-side switch per motor: R1-R4 limit the gate current, R5-R8 hold the gates low while the ESP32 boots, D1-D4 clamp the motor's flyback
Motor drivers
M0 · front right · CCW · IO1
M1 · back right · CW · IO2
M2 · back left · CCW · IO16
M3 · front left · CW · IO4
RESET
BOOT

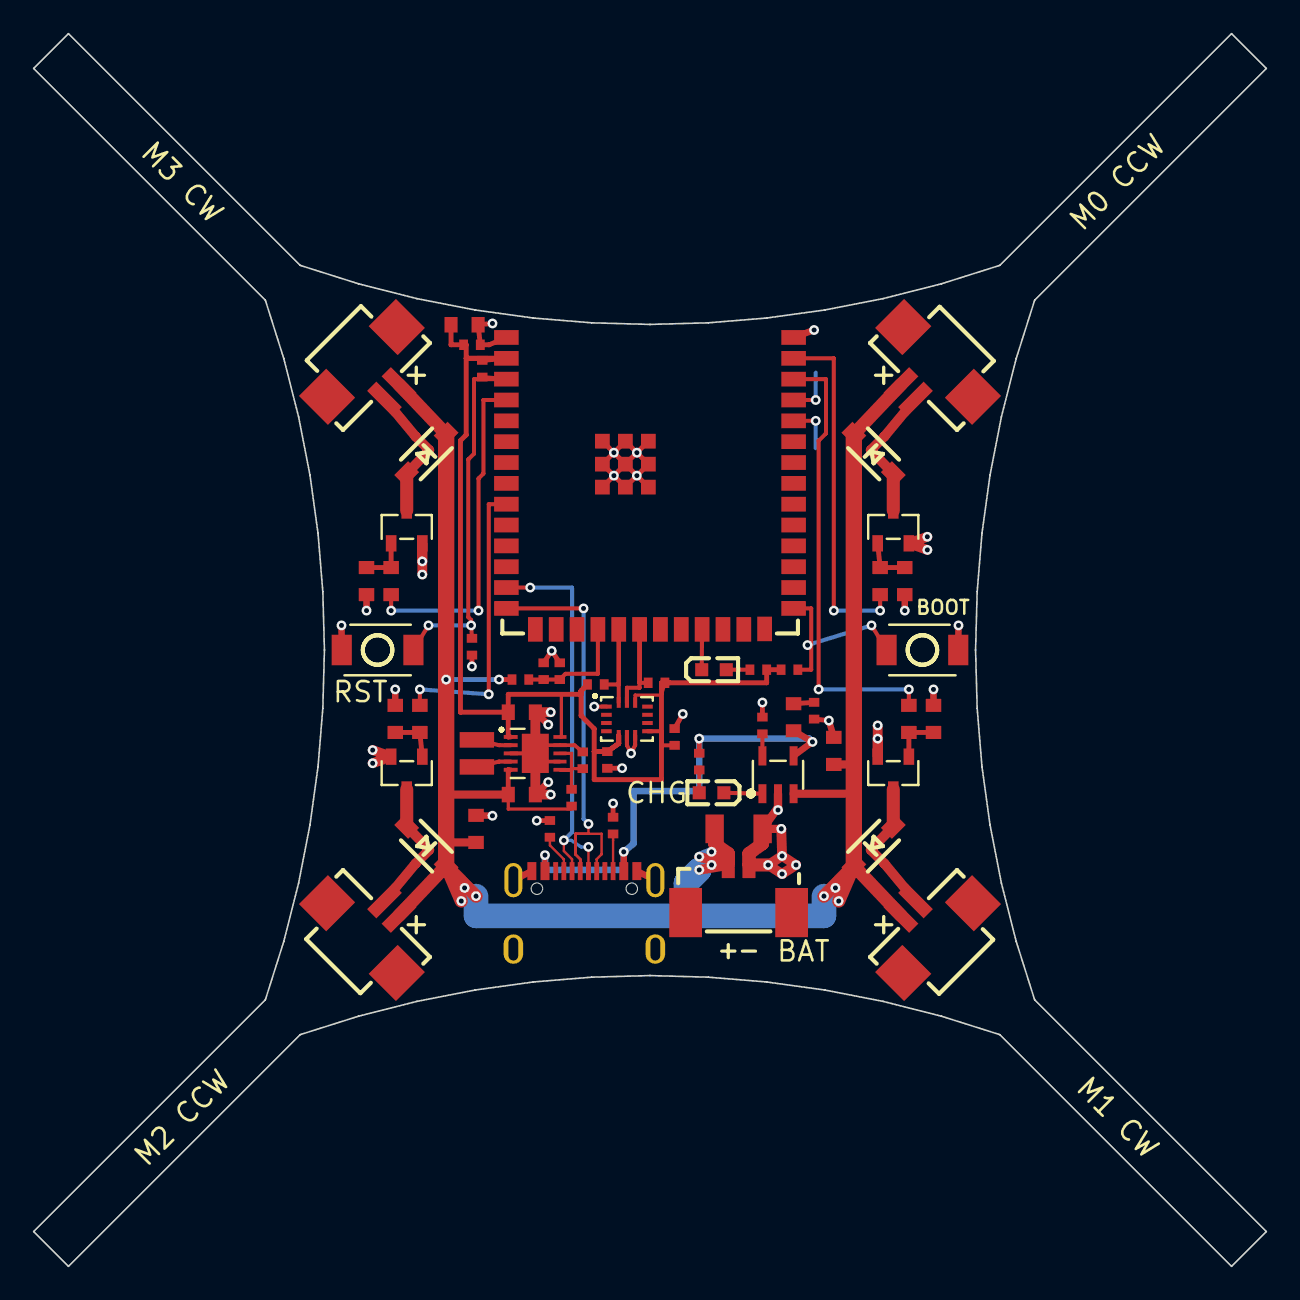
[picture p24: board quad.kicad_pcb from above]

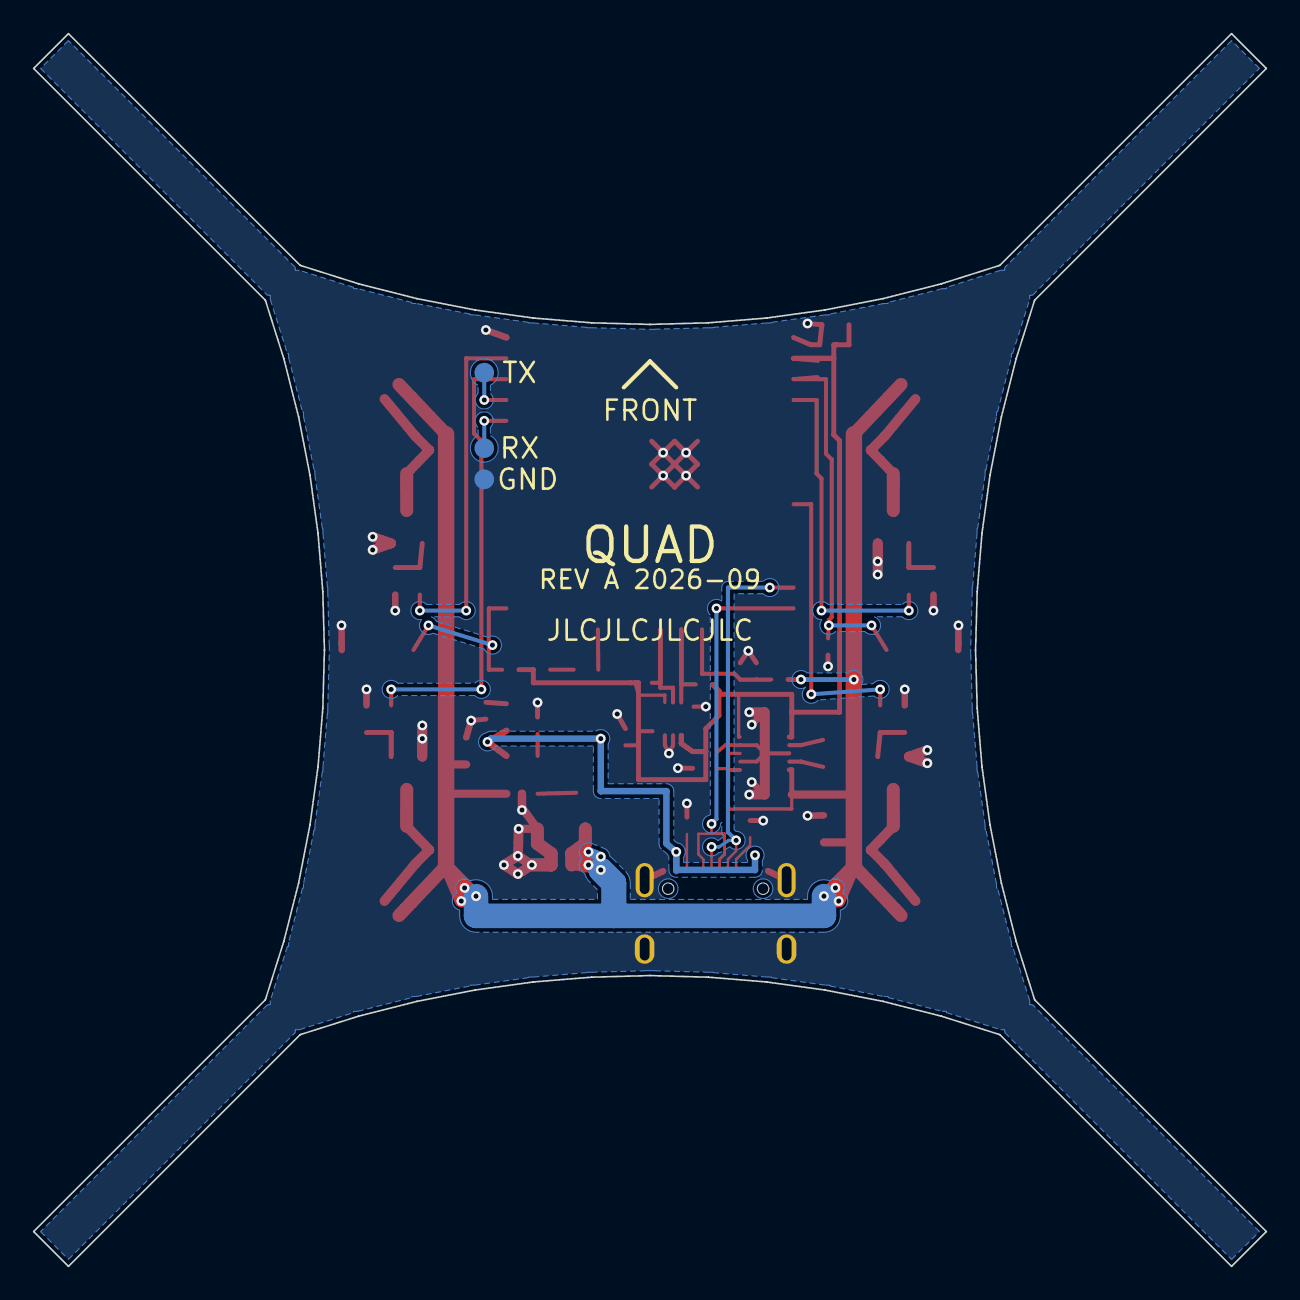
[picture p25: board quad.kicad_pcb from below]

Board: 2 copper layers, 75.1 x 75.1 mm, 60 parts (3 on the bottom side), 36 nets.
