markusheimerl/quadcopter/(commit log)

2023-11-17 Setup KiCad project
    [drone.kicad_pcb, drone.kicad_sch]
2023-11-17 Initial project content
    [drone.kicad_sch, fpga.kicad_sch, imu.kicad_sch, motors.kicad_sch, power.kicad_sch, rf.kicad_sch]
2023-11-18 Added FPGA power component
    [drone.kicad_sch, fpga.kicad_sch, imu.kicad_sch, memory.kicad_sch, motors.kicad_sch, power.kicad_sch, rf.kicad_sch]
2023-11-18 Prepare for power curcuit changes
    [drone.kicad_sch, power.kicad_sch]
2023-11-18 Integrated MPM3833C
    [power.kicad_sch, rf.kicad_sch]
2023-11-18 Moved USB-C connector to root sheet
    [drone.kicad_sch, fpga.kicad_sch, power.kicad_sch]
2023-11-18 Removed RF module for now
    [drone.kicad_sch, fpga.kicad_sch, imu.kicad_sch, motors.kicad_sch, power.kicad_sch]
2023-11-18 Rewired power module
    [drone.kicad_sch, power.kicad_sch]
2023-11-18 Removed RF schematic
    [rf.kicad_sch]
2023-11-18 Replacing global power labels with hierarchical pins
    [drone.kicad_sch, fpga.kicad_sch, imu.kicad_sch, motors.kicad_sch, power.kicad_sch]
2023-11-18 Gathering memory components
    [drone.kicad_sch, fpga.kicad_sch, imu.kicad_sch, memory.kicad_sch, motors.kicad_sch, power.kicad_sch]
2024-08-09 README.md -> Added kicad-cli export command
2024-08-09 Add schematic.png and show.py
2024-08-09 Remove schematic.png and show.py
2024-08-09 Updated KiCad Version of files
    [drone.kicad_sch, fpga.kicad_sch, imu.kicad_sch, memory.kicad_sch, motors.kicad_sch, power.kicad_sch]
2024-08-09 Exchanged flash for same one as on the gatemate dev board
    [memory.kicad_sch]
2024-08-09 Added programmer for FPGA
    [fpga.kicad_sch, memory.kicad_sch]
2024-12-21 Refactor rasterizer to sim and update Makefile; add ground.obj for simulation
    [drone.obj, ground.obj]
2024-12-21 Update camera position and drone state initialization in simulation
2024-12-21 Clamp drone's linear position to a minimum height and reset vertical velocity in dynamics update
2024-12-22 Refactor mesh initialization to create a grid of ground meshes and update rendering logic
2024-12-22 Revert "Refactor mesh initialization to create a grid of ground meshes and update rendering logic"
2024-12-22 Add additional vertices and faces to ground.obj for enhanced terrain detail
    [ground.obj]
2024-12-22 Add detailed vertices and faces to ground.obj for improved terrain representation
    [ground.obj]
2024-12-22 Prevent drone from going below the ground in dynamics update
2024-12-22 Add vertical flipping for GIF frames and refactor vertex shader to handle multiple meshes
2024-12-22 Remove unused camera_up parameter from vertex_shader function and adjust main function accordingly
2024-12-22 Transform ground mesh and update drone mesh dynamics in main simulation loop
2024-12-22 Optimize main simulation loop by removing redundant frame buffer clearing and clarifying rendering comments
2024-12-22 Clear frame buffer before rendering to prevent visual artifacts
2024-12-22 Update rasterizer submodule and adjust file paths; remove unused BMP and OBJ headers
    [drone.obj, ground.obj]
2024-12-22 Enhance README with simulation GIF and adjust quad motor speeds for improved stability
2024-12-23 Refactor motor speed limits and force/moment calculations for improved clarity and performance
2024-12-23 Implement drone physics update function with motor speed limits and thrust calculations
2024-12-26 Refactor drone control logic to separate rotor speed updates and improve code clarity
2024-12-26 Revert "Refactor drone control logic to separate rotor speed updates and improve code clarity"
2024-12-26 Refactor update_drone_control to streamline rotor speed calculations and improve code clarity
2024-12-27 Update yaw initialization and increase simulation steps for improved accuracy
2024-12-27 Refactor update_drone_physics for improved clarity and organization of torque calculations
2024-12-27 Add linear acceleration calculation in body frame for accelerometer simulation
2024-12-27 Add omega_next array and update_rotor_speeds function for rotor speed management
2024-12-27 Reduce stability threshold for angular velocity check in simulation
2024-12-27 Refactor rotation matrix update and adjust stability threshold for angular velocity check
2024-12-28 Refactor stability check function to use angular velocity directly and simplify parameters
2024-12-29 Refactor simulation loop to improve control flow and remove unnecessary variables
2025-01-07 Refactor drone control logic to improve velocity error calculation and update logging format
2025-01-07 Modify random velocity assignment to reduce frequency of updates for improved simulation stability
2025-01-07 Clamp rotor speeds to defined limits and refine divergence conditions for improved simulation accuracy
2025-01-08 Adjust random velocity assignment to enhance variability in simulation dynamics
2025-01-08 Switch compiler from GCC to Clang for improved performance and compatibility
2025-01-08 Add sensor variables for accelerometer and gyroscope; remove unused linear acceleration variable
2025-01-08 Add noise modeling for sensor readings; initialize bias variables for accelerometer and gyroscope
2025-01-08 Add bias variables for accelerometer and gyroscope in sensor header
2025-01-08 Fix yaw angle calculation to ensure it remains within the range [0, 2π] in simulation output
2025-01-11 Update Makefile and simulation logging to track state data and implement discounted rewards
2025-01-13 Refactor simulation initialization and rendering functions; remove unused sensor initialization and streamline mesh loading
2025-01-13 Fix memory allocation in reset_quad function and update print format; remove redundant free call in free_sim function
2025-01-14 Update target index in output and adjust progress print frequency for better clarity
2025-01-18 Refactor quad dynamics calculations for improved performance and clarity; optimize thrust and torque computations using BLAS
2025-01-18 Refactor quad dynamics calculations to streamline thrust and torque computations; combine related operations for improved clarity and performance
2025-01-23 Remove drone kicad files
    [drone.kicad_pcb, drone.kicad_sch, fpga.kicad_sch, imu.kicad_sch, memory.kicad_sch, motors.kicad_sch, power.kicad_sch]
2025-01-23 Add installation instructions for KiCad 8.0 to README.md
2025-01-25 Add new KiCad library files for quad components and footprints
    [quad.kicad_pcb, quad.kicad_sch]
2025-01-25 Update README.md with new schematic and PCB images
2025-01-25 Add initial raytracer implementation with Makefile and basic structure
    [drone.obj]
2025-01-25 Refactor camera setup and ray direction calculation in render function
2025-01-27 Implement camera struct and refactor render function to use camera parameters
2025-01-27 Add support for multiple meshes in rendering: refactor main function to load and render multiple meshes, and implement render_scene function for batch processing
    [treasure.obj]
2025-01-27 Refactor rendering system: introduce Scene struct for better management of meshes and camera, and update main function to utilize new scene handling
2025-01-27 Add ground mesh to scene: include ground.obj and update main function to load it
    [ground.obj]
2025-01-27 Update camera and light direction in scene setup: adjust camera position and normalize light direction vector
2025-01-27 Add mesh transformation support: implement Transform struct and set_mesh_position function, update scene setup to position meshes correctly
    [main.c, scene.h]
2025-01-27 Add frame-based animation support: modify scene structure to handle multiple frames, update rendering loop for animated meshes, and implement WebP animation saving
2025-01-27 Refactor scene creation to accept duration and frame rate; reintroduce progress bar for rendering feedback
2025-01-27 Refactor simulation code: replace sim.c with main.c, update Makefile, and modify .gitignore
    [main.c]
2025-01-27 Enhance simulation: add random yaw initialization and update control input for quadcopter
2025-01-27 Remove hardcoded position for ground mesh in raytracer
2025-02-09 Remove clamping of omega values in update_quad function
2025-02-09 Refactor Quad structure: remove sensor variables and noise calculations from update_quad function; adjust scene resolution in simulation
2025-02-09 Refactor quad.h: remove noise and bias definitions, and eliminate print_quad function
2025-02-09 Add symbolic dynamics calculations for rotorcraft: define state variables, thrust, torques, and gradients
2025-02-09 Implement symbolic dynamics for quadrotor: compute rotor forces, moments, thrust, and angular dynamics with Jacobians
2025-02-10 Refactor control_quad function: change control_input parameter to const and replace direct access with thrust variable for clarity
2025-02-10 Refactor main simulation loop: consolidate target position and yaw into a single array, update scene frame count based on simulation time, and improve readability of control updates and rendering log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
2025-02-13 Refactor simulation to calculate yaw dynamically and adjust simulation duration
2025-02-19 Revert "Refactor simulation to calculate yaw dynamically and adjust simulation duration"
2025-02-19 Adjust yaw calculation range and update velocity constant in simulation
2025-02-19 Add IMU measurement updates for acceleration and gyroscope in Quad structure
2025-02-19 Add bias and scale factors for accelerometer and gyroscope measurements in Quad structure
2025-02-19 Implement attitude estimator for quadcopter using gyroscope and accelerometer measurements
2025-02-20 Refactor update_estimator function to accept gyro and accel measurements as parameters
2025-02-20 Refactor control_quad function to accept position, velocity, and inertia parameters; update simulation to use new function signature
2025-02-20 Refactor update_estimator function to improve accelerometer normalization and correction application; streamline rotation matrix update process
2025-02-20 Refactor estimator implementation to use StateEstimator structure; enhance bias correction and angular velocity estimation
2025-03-06 Add yaw parameter to create_quad function and update initialization in main simulation
2025-03-06 Enhance drone simulation: add random position and yaw initialization, calculate target yaw, and improve control logic for smoother movement
2025-03-06 Refactor drone simulation: update yaw calculation for target orientation, improve variable naming, and enhance mesh management
2025-03-07 Refactor drone simulation: randomize target position and yaw, improve logging for clarity
2025-03-07 Enhance quad simulation: add magnetometer measurements and bias handling, update estimator to include yaw correction from magnetometer data
2025-03-07 Revert "Enhance quad simulation: add magnetometer measurements and bias handling, update estimator to include yaw correction from magnetometer data"
2025-03-08 Enhance quad simulation: add magnetometer measurements, bias, and scale factors; update measurement logic in the update function
2025-03-08 Update magnetometer vector in quad simulation; improve logging for drone and target positions
2025-03-08 Revert "Update magnetometer vector in quad simulation; improve logging for drone and target positions"
2025-03-08 Revert "Enhance quad simulation: add magnetometer measurements, bias, and scale factors; update measurement logic in the update function"
2025-03-11 Enhance quad simulation: modify create_quad function to accept sensor scale factors; update update_quad_states to use provided noise inputs for bias and measurement noise
2025-03-11 Revert "Enhance quad simulation: modify create_quad function to accept sensor scale factors; update update_quad_states to use provided noise inputs for bias and measurement noise"
2025-06-11 Update repository to blcd version
    [ProPrj_2025_06_05_quad_2025-06-11.kicad_pcb, ProPrj_2025_06_05_quad_2025-06-11.kicad_sch, quad.kicad_pcb, quad.kicad_sch]
2025-07-19 Remove obsolete footprints and library files for the ProPrj_2025_06_05_quad_2025-06-11 project. This includes the deletion of the R0603, SOT-23-5_L3.0-W1.7-P0.95-LS2.8-BL, SOT-23-5_L3.0-W1.7-P0.95-LS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
    [ProPrj_2025_06_05_quad_2025-06-11.kicad_pcb, ProPrj_2025_06_05_quad_2025-06-11.kicad_sch]
2025-07-19 Add new project files for quadcopter designs and update README to remove old images
    [2025_06_05_quad.epro, 2025_06_24_cam.epro, 2025_07_18_bldc.epro, 2025_07_18_fpga.epro, 2025_07_18_imu.epro]
2025-07-19 Add new .epro file for quadcopter design and update README with usage instructions
    [2025_07_18_ftdi.epro]
2025-07-19 Update README.md with new sections and add FPGA, BLDC, Quad, Camera, IMU, and FTDI images
2025-07-21 Add new .epro file and PCB image for BLDC design
    [2025_07_18_bldc.epro]
2025-07-23 Add new .epro file and PCB image for FPGA design
    [2025_07_18_fpga.epro]
2025-07-23 Add new .epro file and PCB schematic images for quadcopter design
    [2025_06_05_quad.epro]
2025-07-23 Update quadcopter PCB image
2025-07-23 Comment out Quad Schematic image in README.md
2025-07-23 Update quadcopter .epro file
    [2025_06_05_quad.epro]
2025-07-23 Add new BLDC .epro file and PCB image
    [2025_07_18_bldc.epro]
2025-07-23 Add new FTDI .epro file and PCB image
    [2025_07_18_ftdi.epro]
2025-07-24 Add new IMU .epro file and update PCB and schematic images
    [2025_07_18_imu.epro]
2025-07-24 Add new FPGA .epro file and corresponding PCB image
    [2025_07_18_fpga.epro]
2025-07-24 Add updated BLDC .epro file and corresponding PCB image
    [2025_07_18_bldc.epro]
2025-07-24 Add updated FTDI .epro file and corresponding PCB image
    [2025_07_18_ftdi.epro]
2025-07-25 Add new camera .epro file and corresponding PCB and schematic images
    [2025_06_24_cam.epro]
2025-07-28 Move asset files (.obj and .webp) into assets/ subdirectory
    [drone.obj, ground.obj, treasure.obj]
2025-07-29 Add updated FPGA .epro file and corresponding PCB image
    [2025_07_18_fpga.epro]
2025-08-04 Implement parallelized rendering with configurable thread count
2025-08-04 Optimize default thread count to 2 for best performance
2025-08-05 Remove environment variable configuration and revert README changes
    [scene.c]
2025-08-20 Update FPGA files and images to version 2025_08_20
    [2025_07_18_fpga.epro, 2025_08_20_fpga.epro]
2025-08-20 Update FPGA files and PCB image to version 2025_08_20
    [2025_08_20_fpga.epro]
2025-08-22 Add new IO .epro file and schematic image for version 2025_08_22
    [2025_08_22_io.epro]
2025-08-24 Remove obsolete IO files and add new LEDs files and images for version 2025_08_24
    [2025_08_22_io.epro, 2025_08_24_leds.epro]
2025-08-24 Fix LED PCB image link in README.md
2025-08-25 Remove obsolete FTDI files and add new USB2SPI files and images for version 2025_08_25
    [2025_07_18_ftdi.epro, 2025_08_25_usb2spi.epro]
2025-08-26 Add new USB2UART files and PCB/schematic images for version 2025_08_26
    [2025_08_26_usb2uart.epro]
2025-09-04 Add new BLDC files and PCB/schematic images for version 2025_07_18
    [2025_07_18_bldc.epro]
2025-09-12 Remove obsolete files and add new DC and Flash files with updated images
    [2025_06_05_quad.epro, 2025_06_24_cam.epro, 2025_07_18_bldc.epro, 2025_08_25_usb2spi.epro, 2025_08_26_usb2uart.epro, 2025_09_06_dc.epro, 2025_09_11_flash.epro, 2025_09_11_usb2spi.epro]
2025-09-12 Replace obsolete LED files with new versions and update README.md references
    [2025_08_23_leds.epro, 2025_08_24_leds.epro]
2025-10-03 Add new ESP32 files and update README.md with schematic and PCB images
    [2025_10_02_esp32.epro]
2025-11-16 Add new drone files and update README.md with schematic and PCB images for version 2025_11_15
    [2025_11_15_drone.epro]
2026-05-23 Added latest drone hardware designs
    [ProPrj_2026_05_12_drone_2026-05-23.epro, ProPrj_2026_05_15_drone_2026-05-23.epro]
2026-05-23 Enhance firmware: add BLE support and motor control commands, update CMake configuration, and optimize SDK settings
2026-05-23 Enhance BLE functionality: add log streaming support and improve motor command handling in firmware
2026-06-02 Enhance README: add detailed explanation of desired yaw and body axes orthogonalization for quadcopter control
2026-06-02 Fix README: clarify midpoint angular velocity definition and correct formatting for thrust direction variables
2026-09-27 Add hand-routed ESP32-S3 flight controller PCB (tscircuit) with JLCPCB fab files, KiCad export and updated firmware pin map
    [bom.csv, quad.kicad_pcb, quad.kicad_sch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]
2026-09-27 Replace 3.3 V LDO with TPS63001 buck-boost against brown-outs, fix drill slots/silk/KiCad schematic, add firmware battery and arming safety
    [bom.csv, quad.kicad_pcb, quad.kicad_sch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]
2026-09-27 Move motor connectors out to the May 2026 position (as far along the arms as their tabs allow)
    [quad.kicad_pcb, quad.kicad_sch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]
2026-09-27 Fix gaps from review: firmware safety (heartbeat, stuck/idle disarm, still-and-level calibration, no boot motor sweep, IMU config), BLE client hardening, BAT/polarity silkscreen, ordering and bring-u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
    [quad.kicad_pcb, quad.kicad_sch]
2026-09-28 Rework flight control for a first real hover: flight.c (slow-corrected gravity estimate, angle-rate PID with lift-off-aware integrators) at 500 Hz on 800 Hz IMU data, arrow steering, trim and gain ke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
    [bom.csv, quad.kicad_pcb, quad.kicad_sch]
